melucasleite/mini-kitchen/dados.png

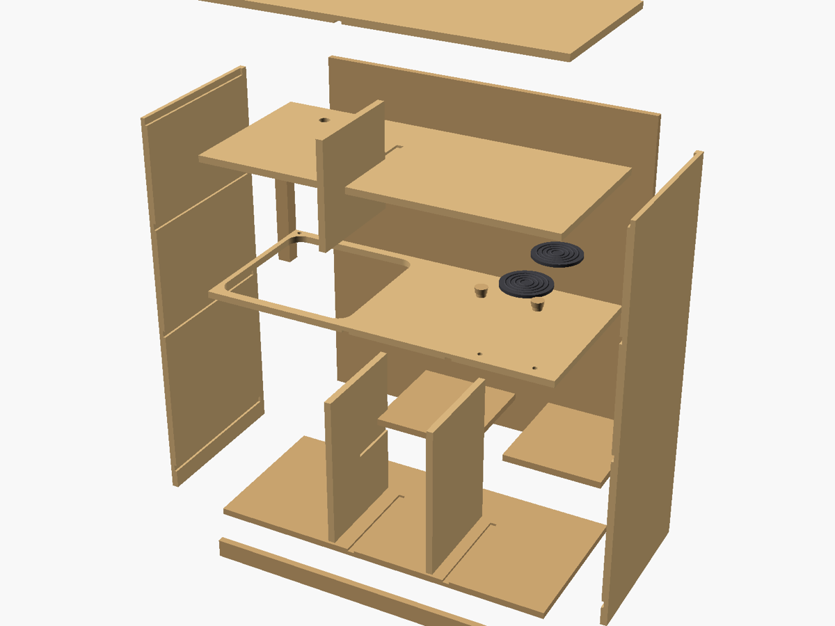
dados.png
