melucasleite/mini-kitchen/front.png

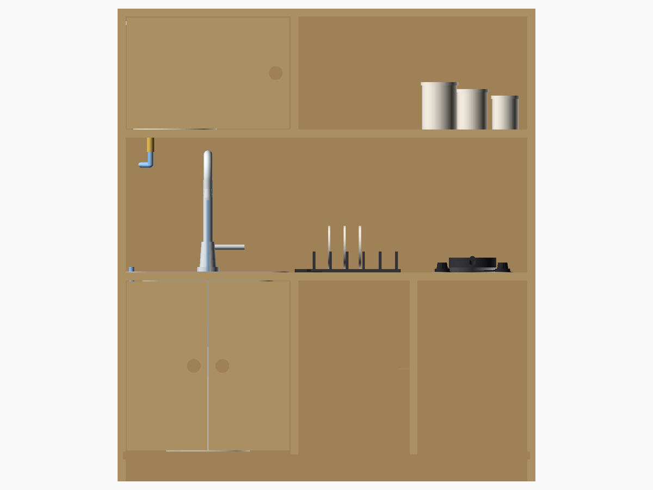
front.png
