melucasleite/mini-kitchen/iso.png

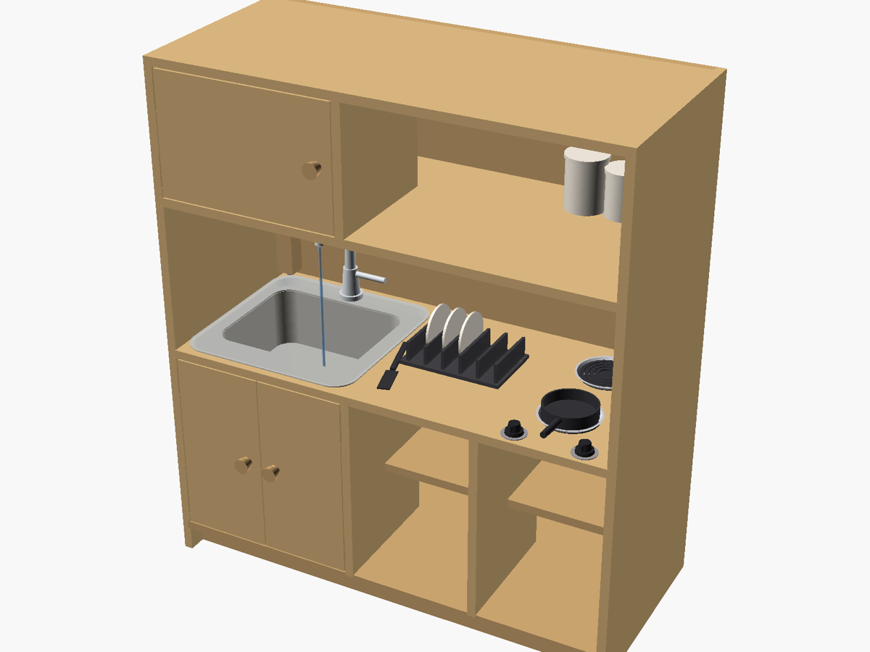
iso.png
