melucasleite/mini-kitchen/open.png

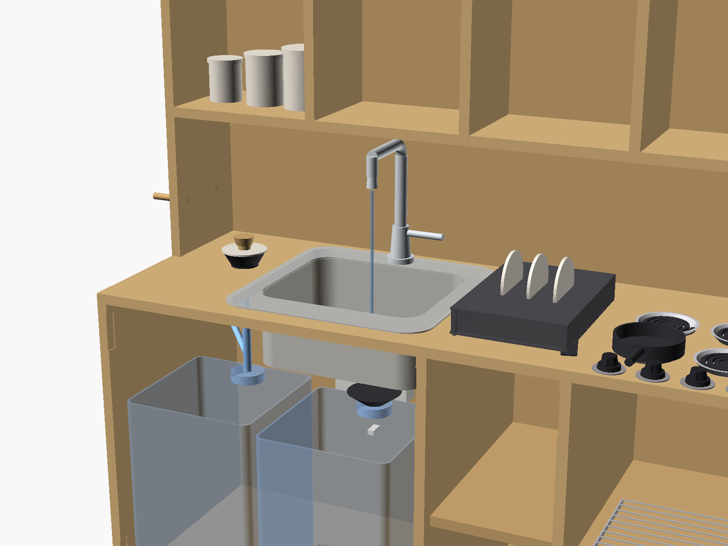
open.png
