melucasleite/mini-kitchen/previews/back-iso.png

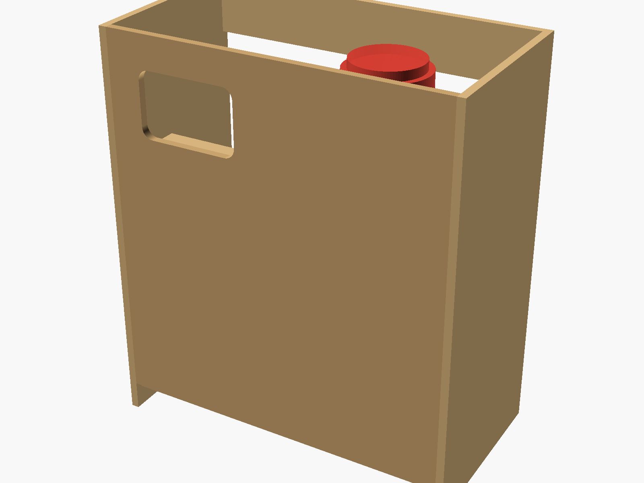
previews/back-iso.png
