melucasleite/mini-kitchen/previews/bay_top.png

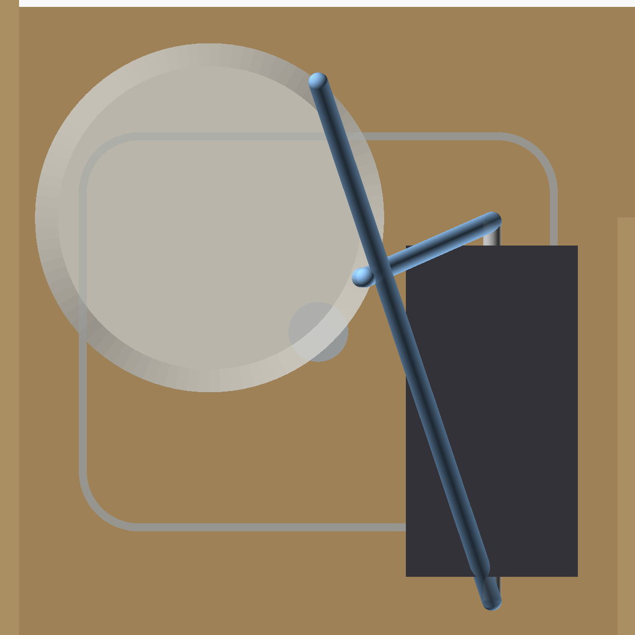
previews/bay_top.png
