melucasleite/mini-kitchen/previews/burner_side.png

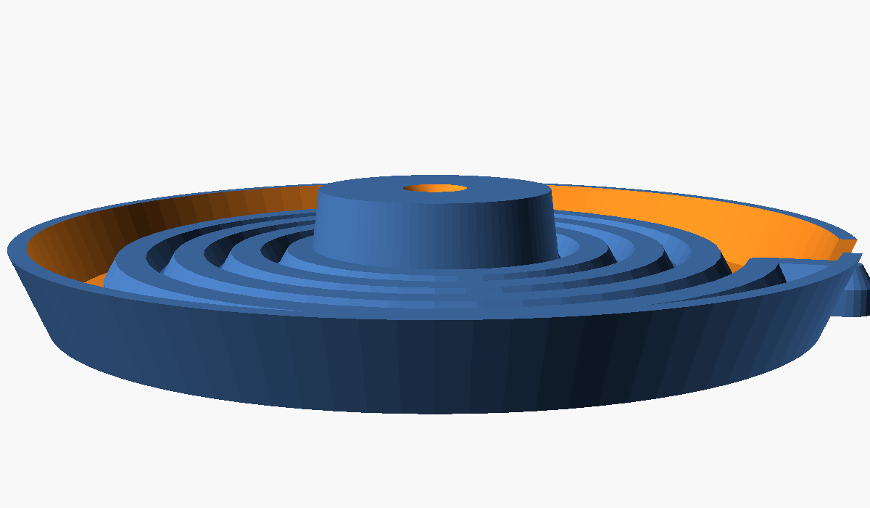
previews/burner_side.png
