melucasleite/mini-kitchen/previews/exploded.png

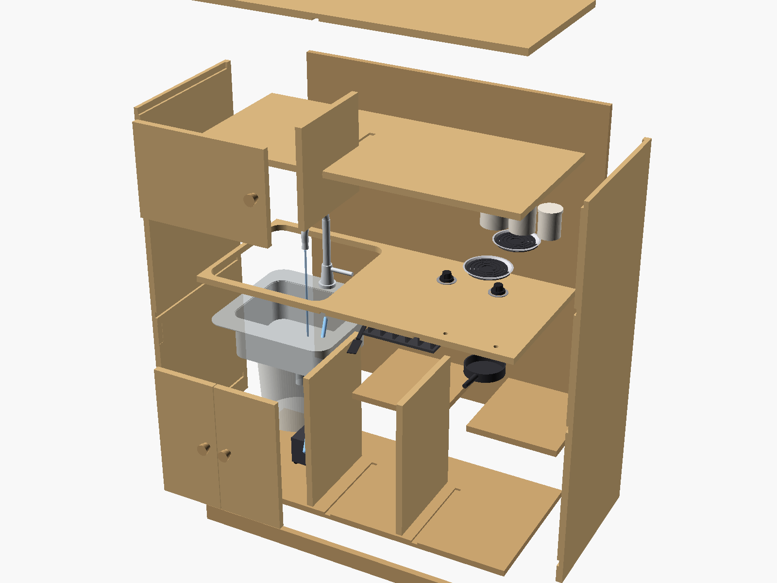
previews/exploded.png
