melucasleite/mini-kitchen/previews/faucet_close.png

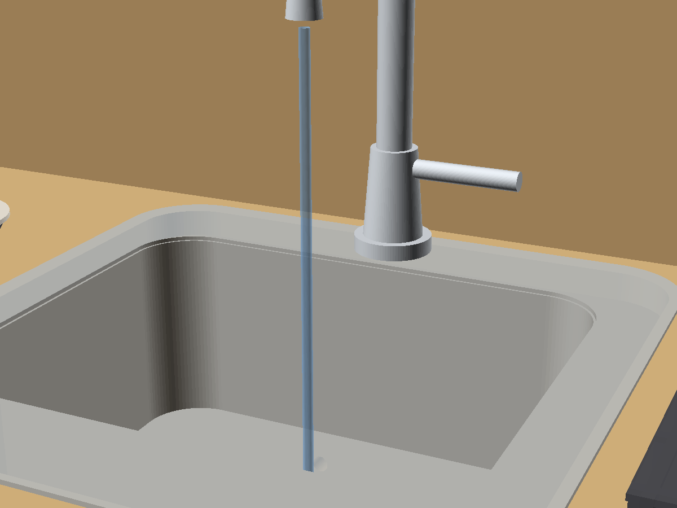
previews/faucet_close.png
