melucasleite/mini-kitchen/previews/front --camera=19,9,21.5,90,0,0,112 --projection=o.png

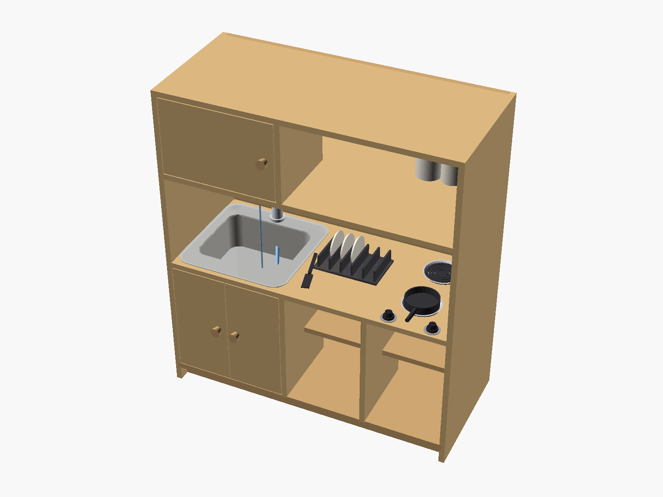
previews/front --camera=19,9,21.5,90,0,0,112 --projection=o.png
