melucasleite/mini-kitchen/previews/front.png

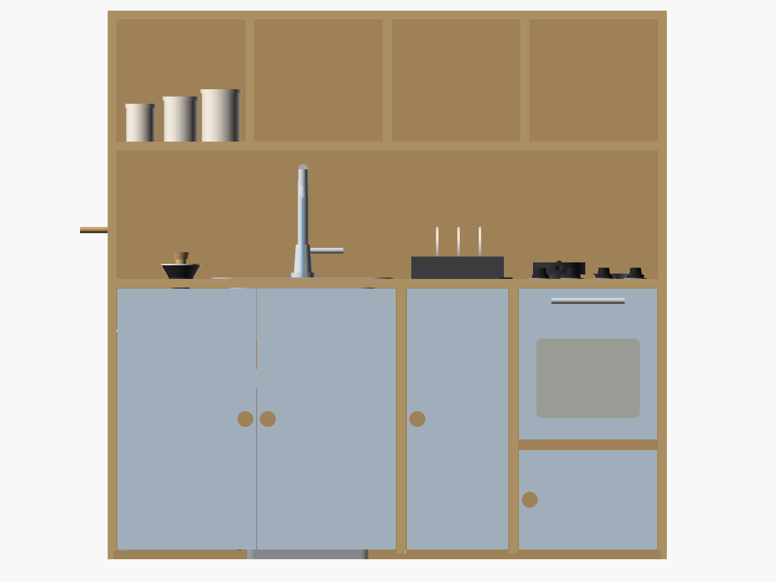
previews/front.png
