melucasleite/mini-kitchen/previews/hole-cover.png

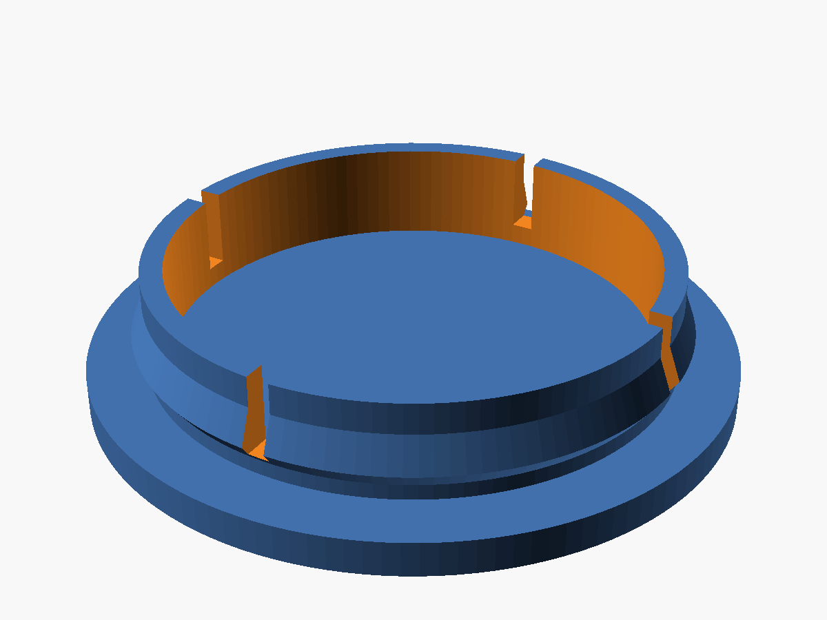
previews/hole-cover.png
