melucasleite/mini-kitchen/previews/iso.png

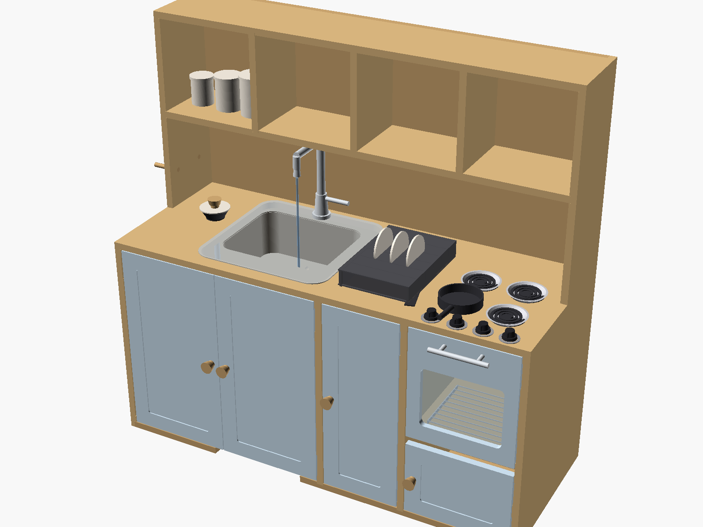
previews/iso.png
