melucasleite/mini-kitchen/previews/open.png

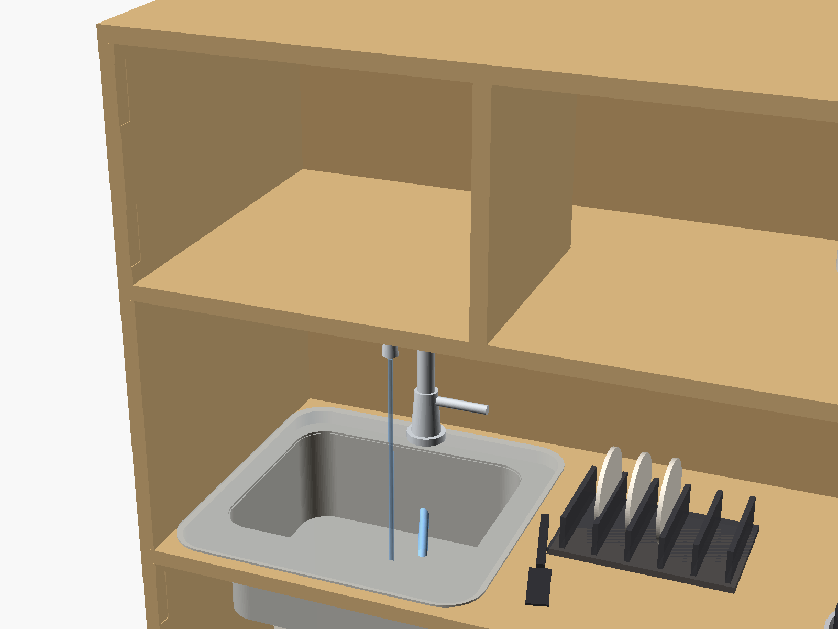
previews/open.png
