melucasleite/mini-kitchen/previews/pickup.png

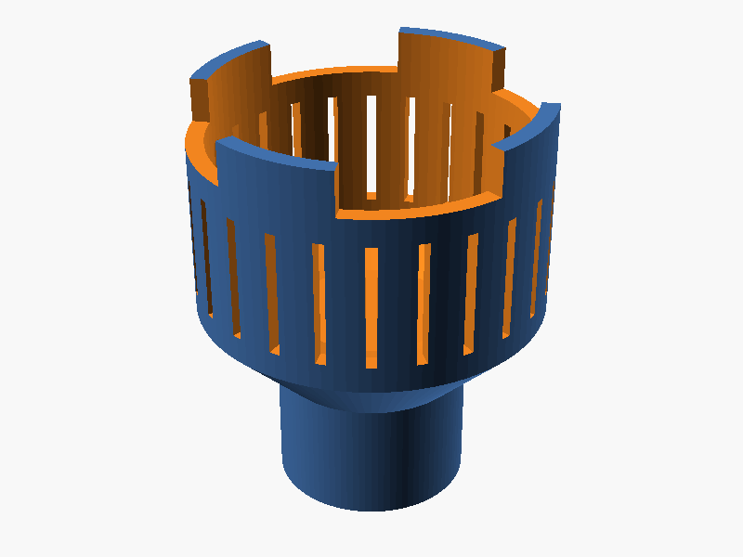
previews/pickup.png
