melucasleite/mini-kitchen/previews/pickup_cut.png

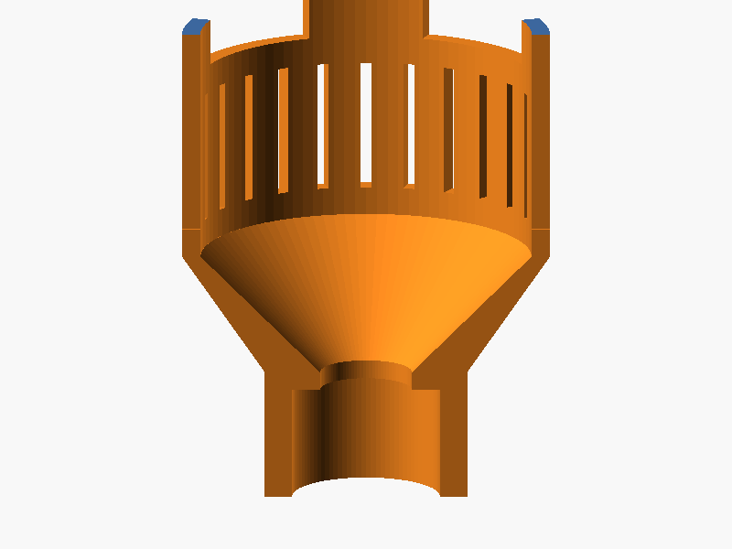
previews/pickup_cut.png
