melucasleite/mini-kitchen/previews/plumbing.png

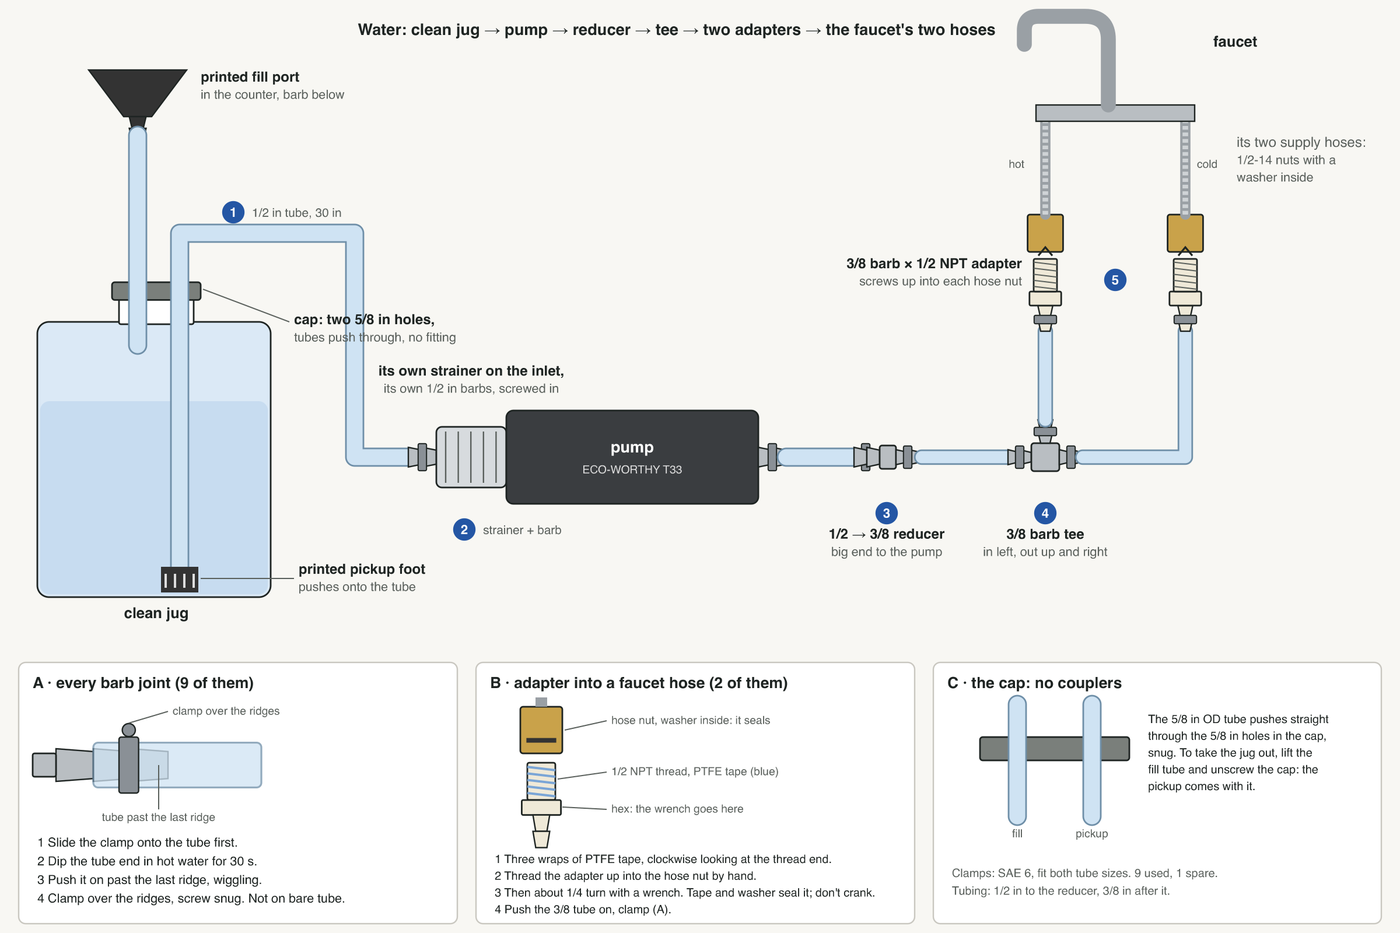
previews/plumbing.png
