melucasleite/mini-kitchen/previews/rack.png

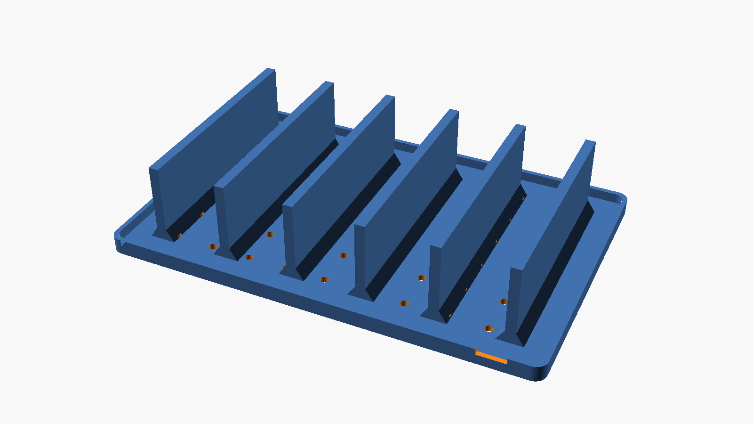
previews/rack.png
