melucasleite/mini-kitchen/previews/sheets/S1-sides-and-kick.svg.png

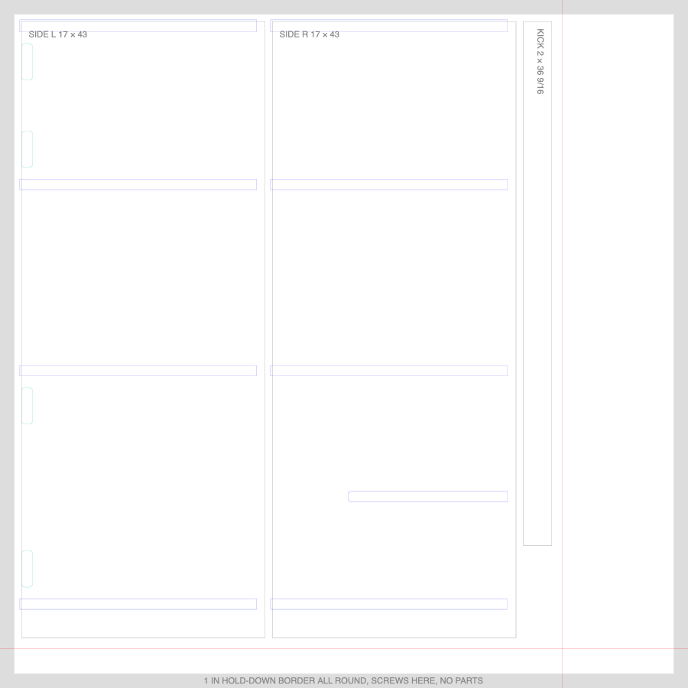
previews/sheets/S1-sides-and-kick.svg.png
