melucasleite/mini-kitchen/previews/sheets/S2-back-and-doors.svg.png

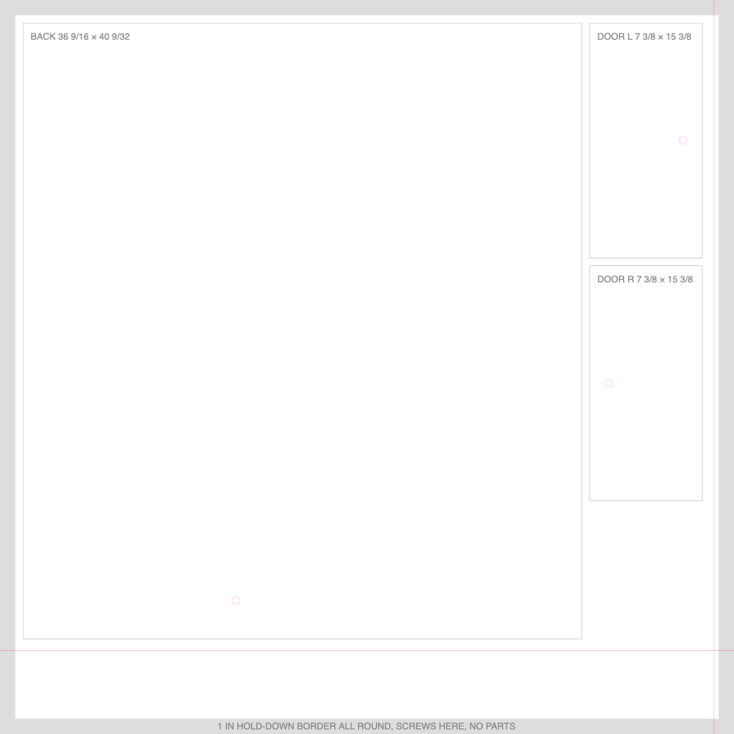
previews/sheets/S2-back-and-doors.svg.png
