melucasleite/mini-kitchen/previews/sheets/S3-counter-bottom-cupboard-door-mid-shelves.svg.png

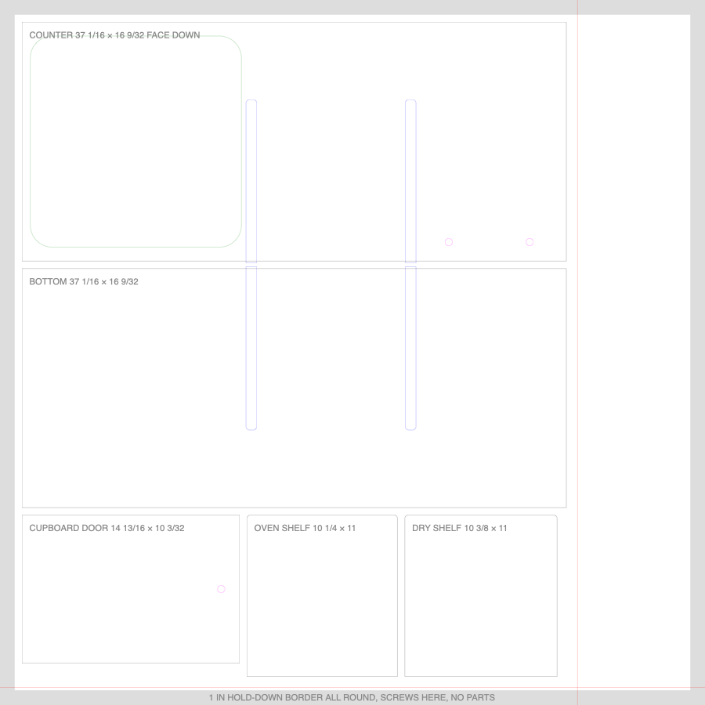
previews/sheets/S3-counter-bottom-cupboard-door-mid-shelves.svg.png
