melucasleite/mini-kitchen/previews/sheets/S4-upper-shelf-top-dividers.svg.png

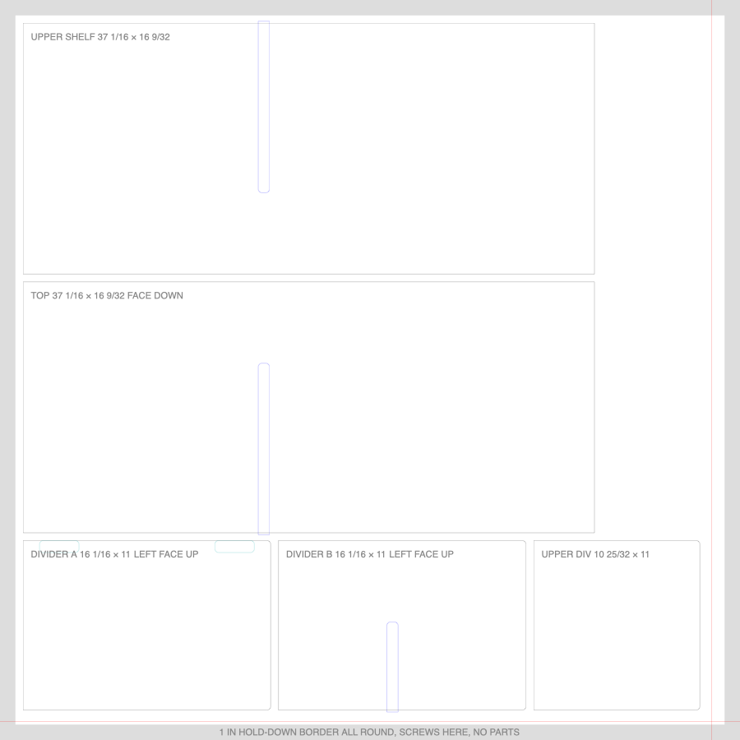
previews/sheets/S4-upper-shelf-top-dividers.svg.png
