melucasleite/mini-kitchen/previews/toys.png

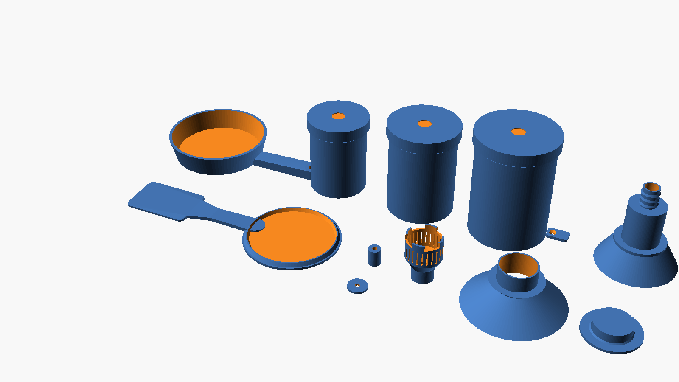
previews/toys.png
