melucasleite/mini-kitchen/previews/under.png

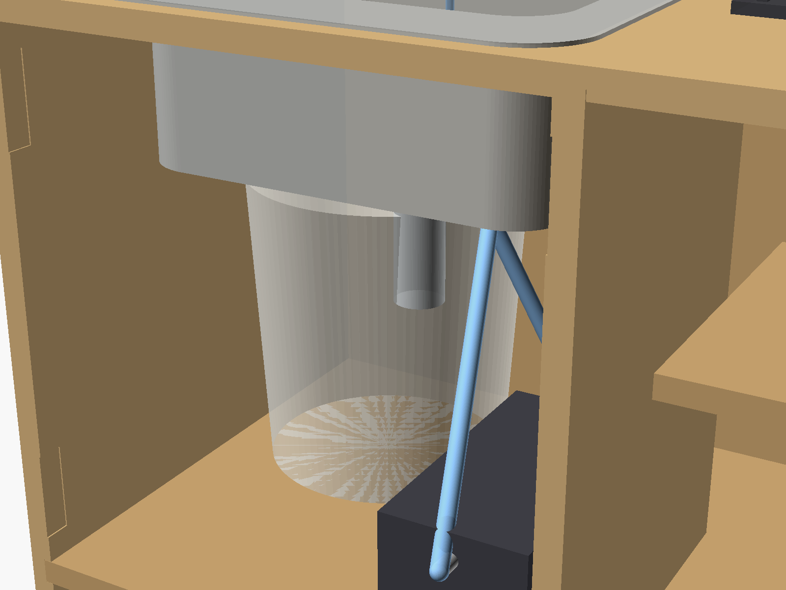
previews/under.png
