melucasleite/mini-kitchen/BOM.md

# Bill of materials

Amazon prices are what was paid on 13 Oct 2026 (two orders, tax on its own line). Plywood, glue, dowel, paint, primer and #8 wood screws are Home Depot, before tax. `[x]` = in hand. Every row counts in the total, including what you already had.
Polyurethane, sandpaper, PTFE thread tape and
filament are assumed on hand. Generated by `gen_html.py` from the same list as the shop sheet.

Water loop: clean jug → printed pickup foot → 1/2 in tube through the jug cap → the pump's own strainer → 12 V demand pump on the back panel → 1/2 to 3/8 barb reducer → 3/8 in tube → tee → one 1/2 NPT × 3/8 barb adapter into each faucet supply nut. Sink → basket strainer → printed funnel in the dirty jug's cap. A fill port in the counter refills the clean jug. The pressure switch runs the pump only while the tap is open; two float switches in series, through a relay, stop it when the clean jug is empty or the dirty jug is full.

| Bought | Item | Store | Each | Qty | Subtotal | Notes |
|:-:|---|---|---:|---:|---:|---|
| | **Wood and finish** | | | | **351.83** | |
| [x] | [PureBond red oak plywood 3/4 in × 4 ft × 8 ft](https://www.homedepot.com/p/Columbia-Forest-Products-3-4-in-x-4-ft-x-8-ft-PureBond-Red-Oak-Plywood-165956/100046409) | Home Depot | 95.00 | 3 | 285.00 | Columbia Forest Products 165956. Three sheets ripped in half make the six 48 × 48 panels on hand; the cut sheets use five. Measured 0.715 to 0.725 in; dados cut 0.735. Budget price, not read from the page. |
| [x] | [Red oak iron-on edge banding, 13/16 in × 50 ft](https://www.amazon.com/dp/B0G43Y98DV) | Amazon | 20.00 | 1 | 20.00 | POWERTEC 72371, pre-glued (the Edge Supply roll went out of stock). About 44 ft used: every front edge of the carcass, the open shelves included, and all four edges of five doors. |
| [x] | [Titebond III wood glue, 8 oz](https://www.homedepot.com/p/Titebond-III-8-oz-Ultimate-Wood-Glue-1413/202960636) | Home Depot | 7.49 | 1 | 7.49 | Titebond 1413. Waterproof. Every dado gets it. |
| [x] | [BEHR Premium cabinet & trim enamel, semi-gloss, 1 qt, light blue](https://www.homedepot.com/p/BEHR-PREMIUM-1-qt-52-White-Semi-Gloss-Enamel-Interior-Exterior-Cabinet-Door-Trim-Paint-712004/312376157) | Home Depot | 23.38 | 1 | 23.38 | The five doors, in a very pale powder blue: pick a light blue at the paint desk and ask for it three steps lighter. Budget price. |
| [x] | [KILZ 2 primer, 1 qt](https://www.homedepot.com/p/KILZ-KILZ-2-ALL-PURPOSE-1-qt-White-Interior-Exterior-Multi-Surface-Primer-Sealer-and-Stain-Blocker-20902/100144601) | Home Depot | 12.98 | 1 | 12.98 | KILZ 20902. One coat on the five doors before the enamel; plywood drinks paint. |
| [x] | [1/2 in × 36 in oak dowel](https://www.homedepot.com/p/Waddell-1-2-in-x-36-in-Oak-Round-Dowel-6512U/100033232) | Home Depot | 2.98 | 1 | 2.98 | Two 3 in pegs cut from it, glued through the left side at her shoulder height: apron and hand towel. Budget price. |
| | **Fasteners** | | | | **30.82** | |
| [x] | [#8 × 1-1/4 in flat head wood screws, 100](https://www.homedepot.com/p/Everbilt-8-x-1-1-4-in-Phillips-Flat-Head-Zinc-Plated-Wood-Screw-100-Pack-801832/204275496) | Home Depot | 7.97 | 1 | 7.97 | Everbilt 801832, zinc. About 89 used: three screws through every dado joint on top of the glue, plus the back, shelves and one through each burner. Countersink them all. |
| [x] | [#6 × 1/2 in flat head wood screws, 100](https://www.amazon.com/dp/B06ZZBG6DC) | Amazon | 7.09 | 1 | 7.09 | Rok Hardware, zinc. Four hold the oven window clips, four the pump's feet, four the wiring box to the back panel and four its lid. |
| [x] | [3/8 in face-grain oak plugs, 100](https://www.amazon.com/dp/B00U0XFVEM) | Amazon | 15.76 | 1 | 15.76 | WidgetCo. Flat plugs for the countersunk heads on the two outside faces and the top, about 36 used. |
| | **Doors and hardware** | | | | **23.65** | |
| [x] | [2-1/2 in stainless butt hinges, 10-pack](https://www.amazon.com/dp/B097QT8DF9) | Amazon | 7.49 | 1 | 7.49 | Zorveiio, satin nickel, 66 × 38 mm, 1.4 mm leaves, screws included. Two on each of the five doors. The cabinet leaf sits flush in a 1.4 mm CNC recess, so the door leaf alone takes up the 3/32 in reveal. |
| [x] | [1.3 in unfinished wood knobs, 20-pack](https://www.amazon.com/dp/B0CJQ4HFDR) | Amazon | 9.99 | 1 | 9.99 | Cangder mushroom knobs, solid wood, M4 × 30 mm screws included. Four on the doors, each on a printed bushing in a 1/2 in CNC hole and centred on the stile, clear of the Shaker panel; one on the fill-port lid. Fifteen spare. The stove knobs are printed. |
| [x] | [6 in stainless bar pull, 96 mm centres](https://www.amazon.com/dp/B01A7D4LIG) | Amazon | 6.17 | 1 | 6.17 | Pandora solid stainless. The oven door handle, above the window; the CNC dimples its two screw holes on the inside face. |
| | **Sink and faucet** | | | | **155.72** | |
| [x] | [Elkay Dayton 15 in drop-in bar sink](https://www.amazon.com/dp/B001289TIS) | Amazon | 74.99 | 1 | 74.99 | D115151. 15 × 15 rim, 12 × 10 × 5 bowl, 2 in drain, one 1 1/2 in faucet hole, 14 3/8 in cutout, clips included. The 5 in bowl leaves room for a 14 in jug under it. It sits 3/4 in back of centre in its bay so the drain lands over the dirty jug's neck. |
| [x] | [ARCORA single-handle bar faucet, brushed nickel, with supply lines](https://www.amazon.com/dp/B0D7PXX12L) | Amazon | 43.19 | 1 | 43.19 | 9.3 in tall under 10 1/2 in of headroom, spout 7 in up, 5 in reach, 1.26 to 1.5 in hole. Hoses end in 1/2-14 NPSM nuts for the adapters below; if yours are 3/8 compression, use 3/8 compression × 3/8 barb fittings (B07DJ451LM) instead. |
| [x] | [Niagara Tri-Max 0.5 / 1.0 / 1.5 GPM aerator](https://www.amazon.com/dp/B0096C2IVC) | Amazon | 8.50 | 1 | 8.50 | Niagara Conservation N3610CH, dual thread, three click-stop flows. Run it on 0.5 so the sink never fills faster than it drains. Play water, not drinking water. |
| [x] | [2 in bar sink drain with basket strainer](https://www.amazon.com/dp/B0G1BCT47B) | Amazon | 9.99 | 1 | 9.99 | Phivan, stainless, fits the Elkay's 2 in drain. Hangs about 1 1/2 in under the bowl, straight over the funnel in the dirty jug. Keeney K5421 (B002JFUOBY) is the fallback. |
| [x] | [1-1/2 in × 6 in sink tailpiece](https://www.amazon.com/dp/B000M2UJSO) | Amazon | 5.99 | 1 | 5.99 | Plumb Pak PP905W. Already in the cart; cut it to a 1 in stub on the strainer to aim the stream into the funnel, or leave it out. |
| [x] | [Plumber's putty, 9 oz](https://www.amazon.com/dp/B006E356S8) | Amazon | 4.54 | 1 | 4.54 | Oatey 31177. Under the strainer flange. |
| [x] | [GE Advanced Silicone 2 kitchen & bath sealant, clear, 2.8 oz](https://www.amazon.com/dp/B000PSE46S) | Amazon | 8.52 | 1 | 8.52 | Bead under the sink rim and around the cutout edge; a thin bead round the acrylic in its pocket. |
| | **Water** | | | | **101.73** | |
| [x] | Two 5 gal square water jugs, 10 × 10 × 14 in | On hand | — | 2 | — | Yours, 2 1/4 in opening at the back edge of the top, both standing neck to the back. Clean on the left: pickup foot inside on its tube through a drilled cap, a side-mount float low on its back wall. Dirty on the right, on the floor in the notch, printed funnel in a 1 1/2 in hole in its cap. Already yours; no price to count. |
| [x] | [ECO-WORTHY 12 V demand pump, 3.5 GPM, 45 psi, with strainer and fittings](https://www.amazon.com/dp/B0BVMDL77Y) | Amazon | 44.99 | 1 | 44.99 | Model T33-12V. Its pressure switch runs it when the faucet opens and stops it when it closes; self-priming, can run dry. Use its own strainer and 1/2 in straight-thread barbs, not NPT. Screwed to the back panel behind the jugs; switch turned toward 25 psi. |
| [x] | [1/2 in ID × 5/8 in OD clear vinyl tubing, 10 ft](https://www.amazon.com/dp/B0CYSM69DW) | Amazon | 8.99 | 1 | 8.99 | Pickup line from the foot in the clean jug up through its cap to the pump's strainer and inlet; pump outlet to the reducer; and 9 in from the fill port down to the cap. About 7 ft used. |
| [x] | [1/2 in to 3/8 in stainless barb reducer, 2-pack](https://www.amazon.com/dp/B088LQCQ4D) | Amazon | 10.99 | 1 | 10.99 | Beduan 304 stainless: 1/2 in tube from the pump on one end, 3/8 in tube to the tee on the other, a clamp on each. One spare. |
| [x] | [3/8 in ID × 1/2 in OD clear vinyl tubing, 10 ft](https://www.amazon.com/dp/B07NQSNBTG) | Amazon | 7.88 | 1 | 7.88 | Eastman 98620, FDA-compliant PVC. About 3 ft used: reducer to tee to the two faucet adapters. |
| [x] | [3/8 in stainless barb tee](https://www.amazon.com/dp/B08G1RJ38P) | Amazon | 8.99 | 1 | 8.99 | Metaland 3/8 × 3/8 × 3/8. Splits the pump's outlet to both faucet supply lines so every handle position gives water. |
| [x] | [3/8 in barb × 1/2 in NPT male nylon adapter, 6-pack](https://www.amazon.com/dp/B08G1833GN) | Amazon | 7.99 | 1 | 7.99 | JoyTube. Screws straight into the faucet's 1/2-14 NPSM supply nuts (the hose's own cone washer seals it), 3/8 in tube on the barb. One per line, four spare. |
| [x] | [SAE 6 stainless hose clamps (3/8 to 7/8 in), 10-pack](https://www.amazon.com/dp/B01MQCU44A) | Amazon | 11.90 | 1 | 11.90 | Covers both tube sizes; one on every barb, nine used, one spare. |
| | **Electrical** | | | | **71.12** | |
| [x] | [12 V 10 A power supply, 120 W, 5.5 × 2.1 mm barrel](https://www.amazon.com/dp/B0D5CKC9V1) | Amazon | 20.98 | 1 | 20.98 | Desktop supply with a barrel-to-screw-terminal adapter in the box. The pump can pull 6 A. Its plug is the adult off switch. |
| [x] | [Side-mount float switch, M16, 2-pack](https://www.amazon.com/dp/B08B4JQHN9) | Amazon | 5.99 | 1 | 5.99 | mxuteuk DPL-1-BK, polypropylene, both used. One through a 5/8 in hole low on the clean jug's back wall, 2 in up: it opens when the water drops below it and the pump stops before it can run dry. The other high on the dirty jug's back wall, 12 in up, set the other way: it opens when the dirty water lifts it, so the sink cannot overfill the jug. In series on the relay coil; rated 0.5 A, so they never carry the pump. |
| [x] | [12 V 30 A automotive relay with socket, 5-pack](https://www.amazon.com/dp/B00RWV470O) | Amazon | 13.59 | 1 | 13.59 | ESUPPORT 5-pin. Both float switches in series on the coil (85/86), supply positive to 30, pump positive off 87: clean jug empty or dirty jug full, no coil, no pump. Lies in the printed wiring box, held by two zip ties. Four spare. |
| [x] | [2-pin waterproof pigtail plugs, 5 pairs](https://www.amazon.com/dp/B01A6LTK44) | Amazon | 7.59 | 1 | 7.59 | MUYI, pre-wired, 4 in of 18 AWG on each half: no crimping. One pair on each float lead at the top of its jug's back wall, joined to the float wires and to the run to the wiring box with in-line lever connectors. Unplug and the jug walks away. Three pairs spare. |
| [x] | [18 AWG two-conductor red/black wire, 25 ft](https://www.amazon.com/dp/B0G9NYN463) | Amazon | 7.99 | 1 | 7.99 | Copper-clad aluminium, fine at 12 V and these lengths. Three runs into the wiring box: the supply pair from the barrel adapter through the cord hole (2 ft), and one pair to each jug's plug (clean about 3 ft, dirty about 2 ft). Red is the float's feed, black its return. |
| [x] | [Lever wire connectors, 32-piece kit](https://www.amazon.com/dp/B0B28GQVVG) | Amazon | 14.98 | 1 | 14.98 | XALXMAW: 18 one-in-one-out, 6 one-in-two-out, 4, 2 and 2 of the bigger splitters; 24–12 AWG. 14 used: three 1-in-2-out and three 1-in-1-out in the wiring box's labelled slots, and four 1-in-1-out at each jug where the float's leads meet its plug and the plug meets the run. Strip, lift the lever, push in, close it: no crimping. |
| | **Oven, stove and dishes** | | | | **52.18** | |
| [x] | [8 × 10 in clear cast acrylic, 1/8 in, 2-pack](https://www.amazon.com/dp/B0CQ2D2VCN) | Amazon | 9.99 | 1 | 9.99 | KAITELA, cast. It drops into the 10 3/16 × 8 3/16 in pocket on the oven door's inside face as it comes, film off, nothing to cut. One spare sheet. |
| [x] | [Stainless cooling rack, 9.7 × 7.3 in, 2-pack](https://www.amazon.com/dp/B07NVBF3W7) | Amazon | 8.29 | 1 | 8.29 | P&P CHEF. One is the oven rack, on the oak oven floor behind the window. The other is a spare or a second shelf. |
| [x] | [Small dish drying rack, 7.7 in wide](https://www.amazon.com/dp/B09SG532Q8) | Amazon | 21.69 | 1 | 21.69 | Rubber-footed slim rack for the drying bay counter, long axis front to back; the bay is 8 1/2 in wide, so anything under 8 in across works. |
| [x] | [#8-32 × 2 in stainless machine screws, 30](https://www.amazon.com/dp/B0G7Y5KY1R) | Amazon | 6.99 | 1 | 6.99 | Twidec, pan head. Four hold the stove knobs: up from under the counter, through a printed washer and the knob's boss, into the nut captured in the knob. |
| [x] | [#8-32 machine screw nuts, 100](https://www.amazon.com/dp/B000BQMMFY) | Amazon | 5.22 | 1 | 5.22 | Hillman, zinc. One drops into the hex pocket in each stove knob before its boss is glued in. |
| | **Safety** | | | | **11.58** | |
| [x] | [Furniture anti-tip strap kit](https://www.amazon.com/dp/B000FJRYAA) | Amazon | 11.58 | 1 | 11.58 | QuakeHOLD! 4160, two 15 in nylon straps. A 45 in hutch with a toddler on the oven door is a ladder. Strap the back to a stud. |
| | **Tax** | | | | **25.94** | |
| [x] | Sales tax on the two Amazon orders, less a $1.05 coupon | Amazon | 25.94 | 1 | 25.94 | $17.93 + $9.06 tax, −$1.05 coupon: the Amazon lines above plus this one come to the $442.70 charged. Home Depot prices are before tax. |

## Printed

All in `printed.scad`, STLs in `stl/`. Black PLA or ASA unless noted.

| Part | Qty | File | Notes |
|---|---:|---|---|
| Drip pan, 4 in | 4 | `stl/drip_pan.stl` | Silver or light grey. Sloped wall, centre hole; the coil's screw clamps it down. About 35 g each. |
| Coil element | 4 | `stl/coil.stl` | Black. Three-turn spiral with a 16 mm centre cap and a terminal tail, drops into the pan. One #8 × 1 1/4 in screw down through the cap holds coil and pan to the counter. About 25 g each. |
| Stove knob body | 4 | `stl/stove_knob.stl` | Black, prints face down, pointer up. The hexagon in the face is a pocket for an 8-32 nut: drop the nut in, glue the boss over it. About 18 g each. |
| Knob boss | 4 | `stl/knob_boss.stl` | The knob's 12.4 mm axle, prints standing. Glues into the knob face and turns in the 1/2 in counter hole; screw and washer from below. 3 g each. |
| Knob bezel | 4 | `stl/bezel.stl` | Tick ring glued round each knob hole, OFF at the back. 5 g each. |
| Knob washer, 20 mm | 4 | `stl/washer.stl` | Under each stove-knob screw head so it slides on the counter's underside when the knob turns. Print six, any colour. |
| Frying pan, 110 mm | 1 | `stl/pan.stl` | Black, prints flat; the handle runs from the base so nothing hangs in the air. About 45 g. |
| Spatula, 180 mm | 1 | `stl/spatula.stl` | Black, prints flat. About 25 g. |
| Plate, 100 mm | 4 | `stl/plate.stl` | Light colour, for the dish rack. About 20 g each; print six if you like. |
| Canisters with lids, S/M/L | 3 | `stl/canister-*.stl, stl/lid-*.stl` | Light colour cans, contrast lids, lids dimple-side down. They live on the first open shelf, where she can see them. About 150 g the set. |
| Door-knob bushing, 1/2 in OD × 3/16 bore | 4 | `stl/bushing.stl` | Presses into each door's CNC'd knob hole so the wood knob's 8-32 screw runs centred. 2 g each; print five. |
| Fill port | 1 | `stl/fill_port.stl` | Prints mouth down, no supports. An 80 mm funnel mouth standing 1 in above the counter, flange on the counter, 36 mm spout through the 1 1/2 in hole, 1/2 in barb below for the tube to the clean jug's cap. She refills the kitchen with her own pitcher. Black, about 45 g. |
| Fill port lid | 1 | `stl/fill_lid.stl` | Prints flat, ring up. An 84 mm disc with a ring that drops into the mouth; a spare wood knob screws to it from the ring side. Any colour, 20 g. |
| Pump pickup foot | 1 | `stl/pickup.stl` | Prints socket-side down, no supports. Slotted cup on four legs on the end of the pickup tube in the clean jug: water comes in through the slots, down the hollow cone and through a 10 mm bore into the tube. 36 mm across, so it drops through the jug's 2 1/4 in neck. Black, about 16 g. |
| Drain funnel | 1 | `stl/funnel.stl` | Prints mouth down, no supports. 100 mm mouth, 37.5 mm spout, 52 mm flange: the spout drops into a 1 1/2 in hole drilled in the dirty jug's cap (a 1 5/8 or 1 3/4 in hole saw works too) and the mouth sits under the strainer. The neck is at the jug's back edge and the drain {frac(DRAIN_OFF)} in from it, well inside the mouth. Black, about 25 g. |
| Cap plug | 2 | `stl/cap_plug.stl` | Prints flat. A disc with a spigot that fills the funnel hole in the dirty jug's cap: funnel out, plug in, carry the jug to the drain without a drip. One spare. Any colour, 10 g. |
| Wiring box | 1 | `stl/wire_box.stl` | Prints floor down, no supports. 152 × 102 × 38 mm. Screws to the back panel over the cord hole on four #6 screws in a rectangle. The relay stands on the right on two zip-tie saddles; six labelled slots in the middle hold the lever connectors on their sides (GND, +12V and SERIES 1-in-2-out; PUMP+, 85 and 87a 1-in-1-out), outputs left toward the outside wires, relay leads into the single ends from the right, so nothing crosses. Three notches let the outside wires in. Slot widths are WB_LCS in printed.scad if your connectors differ. Any colour, about 100 g. |
| Wiring box lid | 1 | `stl/wire_box_lid.stl` | Prints face down. 3 mm plate, four countersunk #6 × 1/2 into the box's corner bosses, vents over the relay coil, tongues that close the wire notches, a keeper bar that stops 1 mm in front of the connectors, 12 V on its face. About 50 g. |
| Oven window clip | 4 | `stl/window_clip.stl` | 22 × 14 × 3 mm plate, countersunk for a #6 × 1/2 screw. Four hold the acrylic in its pocket on the oven door's inside face, one per corner. Any colour, 2 g each. |

## Total

| | |
|---|---:|
| Amazon | 484.77 |
| Home Depot | 339.80 |
| **Total** | **824.57** |
| Still to buy | 0.00 |
