melucasleite/mini-kitchen/previews/parts/bezel.png

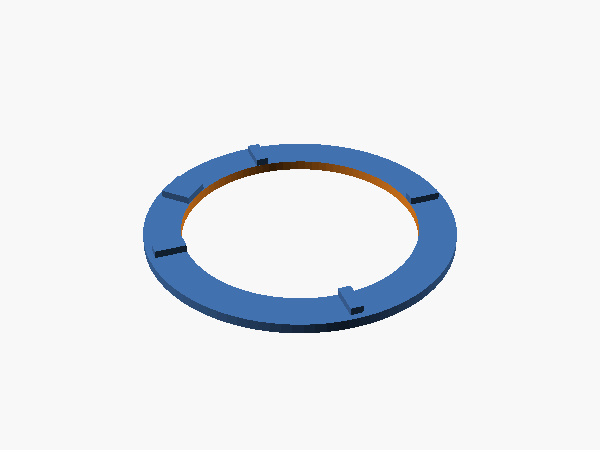
previews/parts/bezel.png
