melucasleite/mini-kitchen/previews/parts/bushing.png

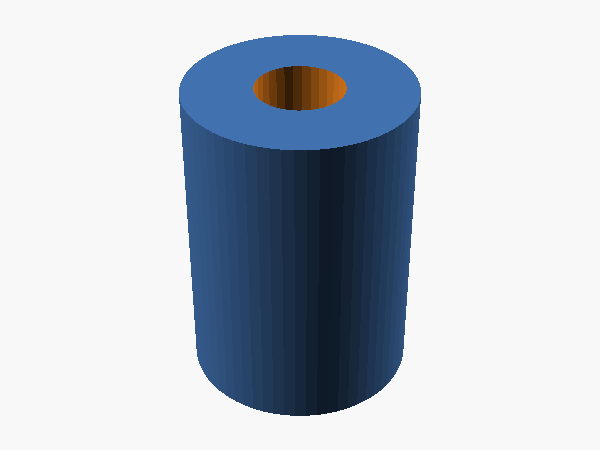
previews/parts/bushing.png
