melucasleite/mini-kitchen/previews/parts/cap_plug.png

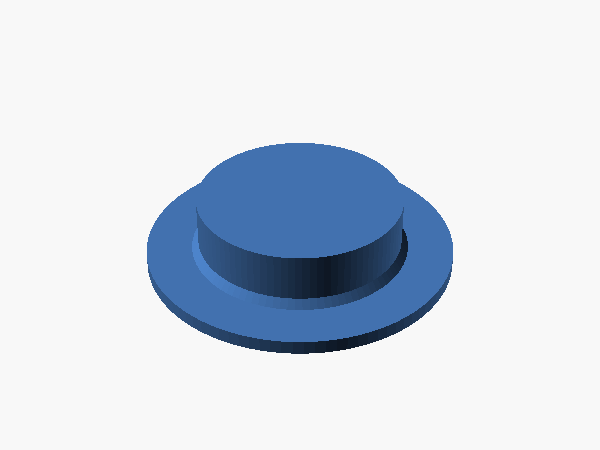
previews/parts/cap_plug.png
