melucasleite/mini-kitchen/previews/parts/coil.png

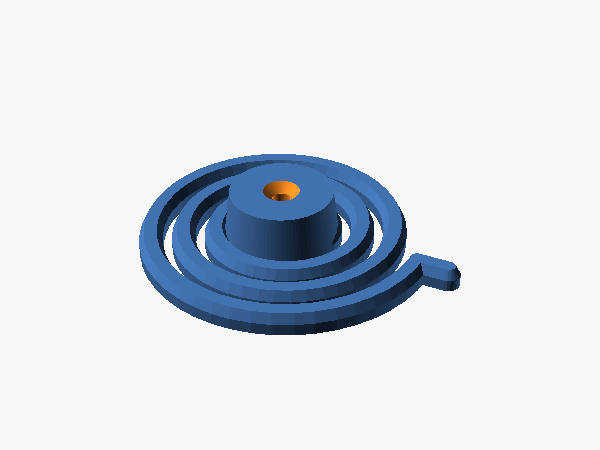
previews/parts/coil.png
