melucasleite/mini-kitchen/previews/parts/drip_pan.png

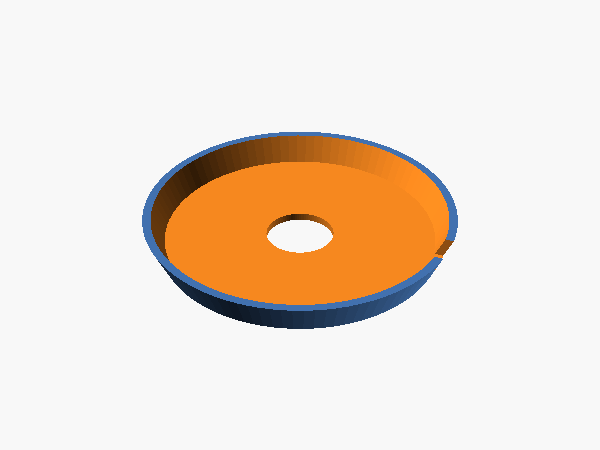
previews/parts/drip_pan.png
