melucasleite/mini-kitchen/previews/parts/fill_port.png

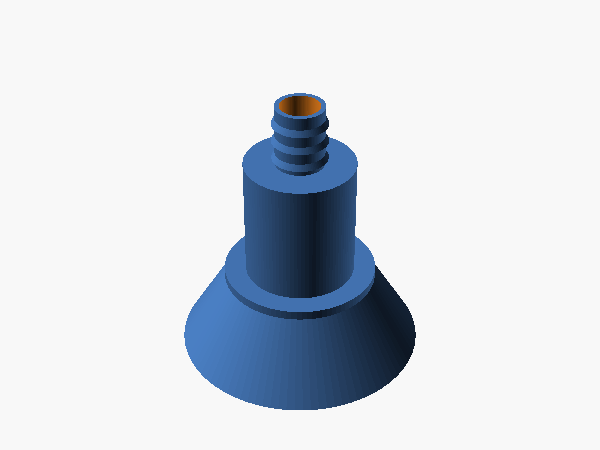
previews/parts/fill_port.png
