melucasleite/mini-kitchen/previews/parts/knob_boss.png

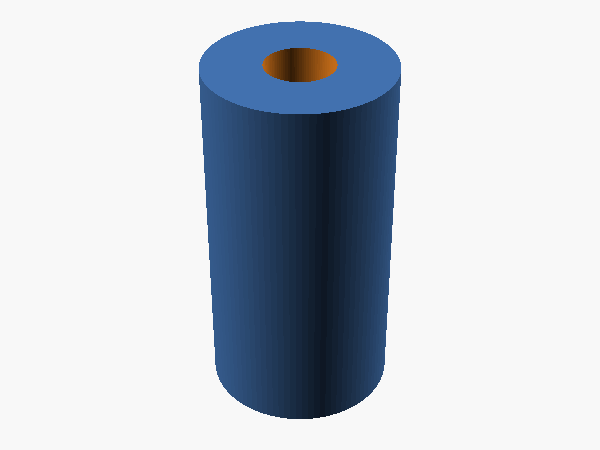
previews/parts/knob_boss.png
