melucasleite/mini-kitchen/previews/parts/lid-L.png

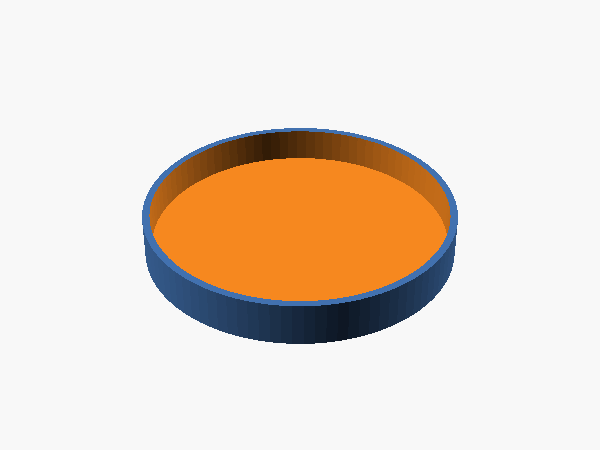
previews/parts/lid-L.png
