melucasleite/mini-kitchen/previews/parts/pan.png

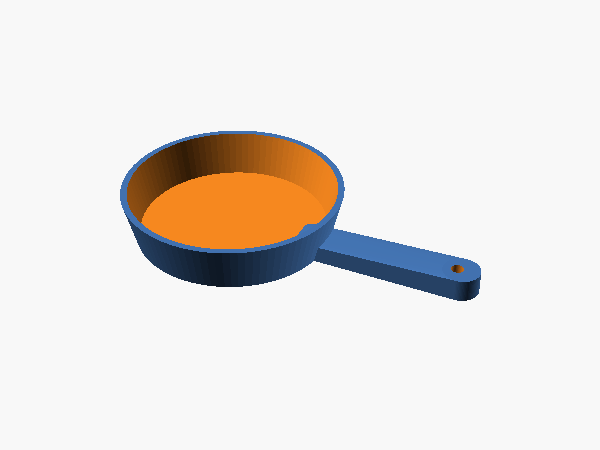
previews/parts/pan.png
