melucasleite/mini-kitchen/previews/parts/pickup.png

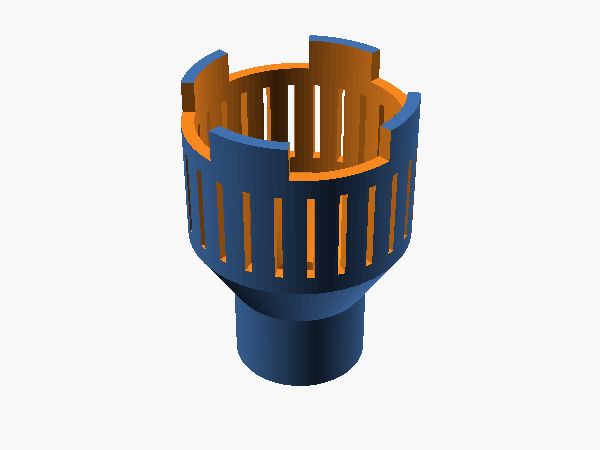
previews/parts/pickup.png
