melucasleite/mini-kitchen/previews/parts/plate.png

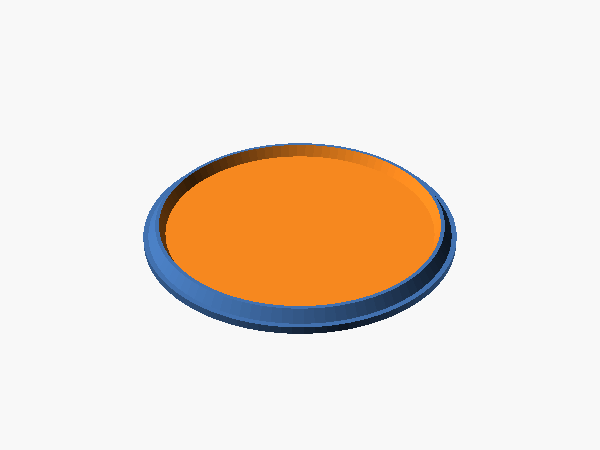
previews/parts/plate.png
