melucasleite/mini-kitchen/previews/parts/spatula.png

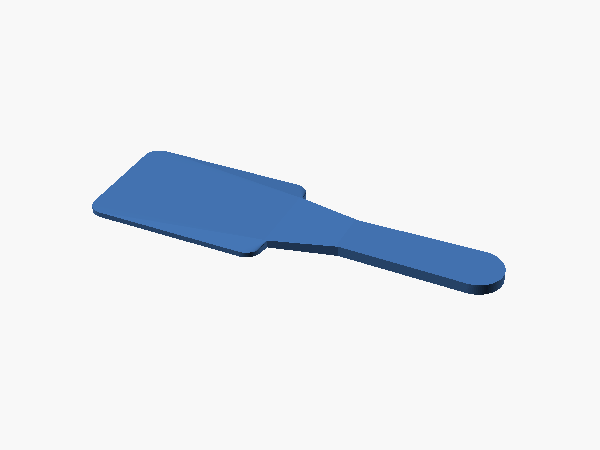
previews/parts/spatula.png
