melucasleite/mini-kitchen/previews/parts/stove_knob.png

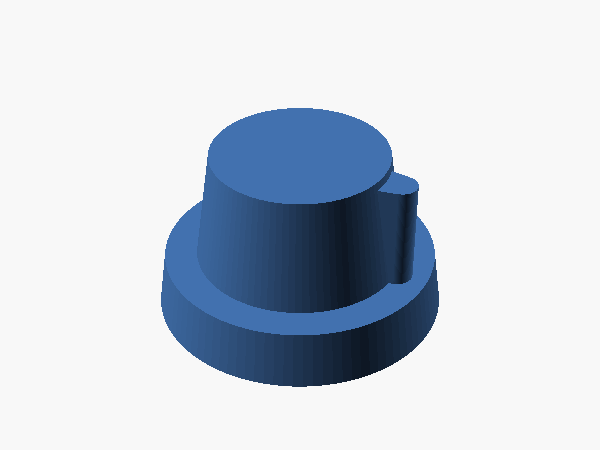
previews/parts/stove_knob.png
