melucasleite/mini-kitchen/previews/parts/window_clip.png

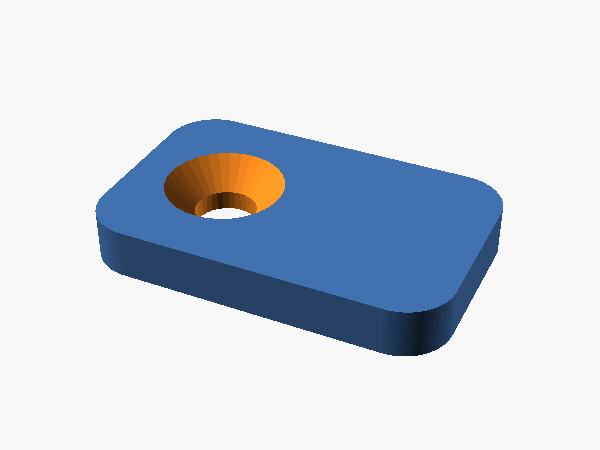
previews/parts/window_clip.png
