melucasleite/mini-kitchen/previews/parts/wire_box.png

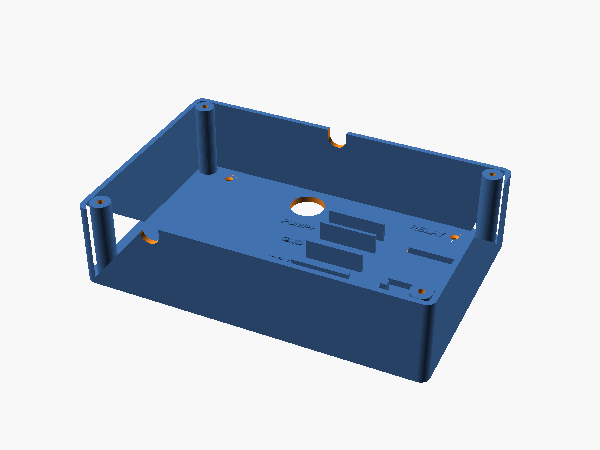
previews/parts/wire_box.png
