melucasleite/mini-kitchen/previews/parts/wire_box_lid.png

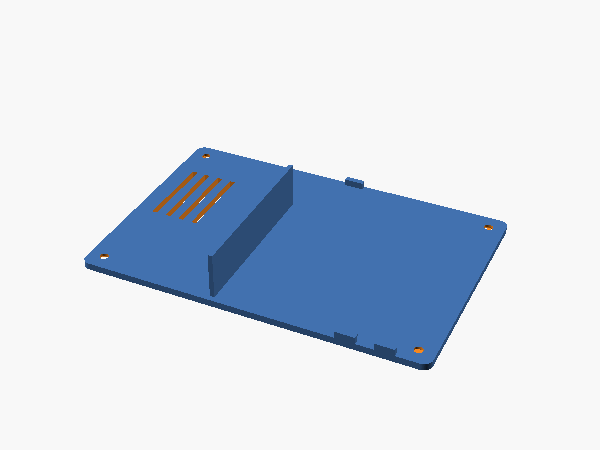
previews/parts/wire_box_lid.png
