melucasleite/mini-kitchen/plates/plate-3-drip-pans-silver.3mf

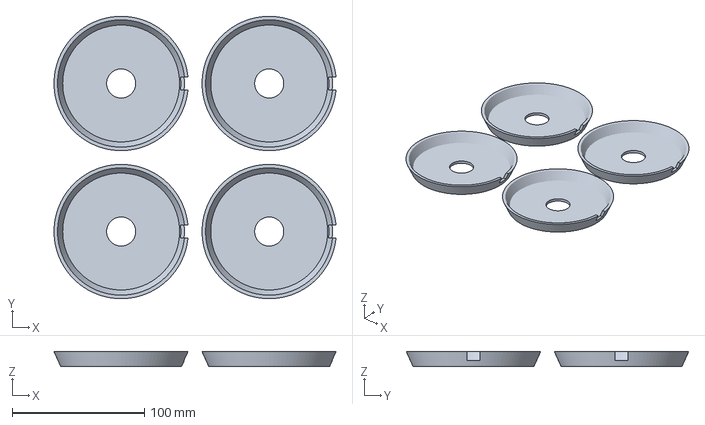
[picture p49: CAD file, 2026-10-24]
plates/plate-3-drip-pans-silver.3mf
213.3 x 213.6 x 11.0 mm
drip pan 1 x 4
