melucasleite/mini-kitchen/stl/pan.stl

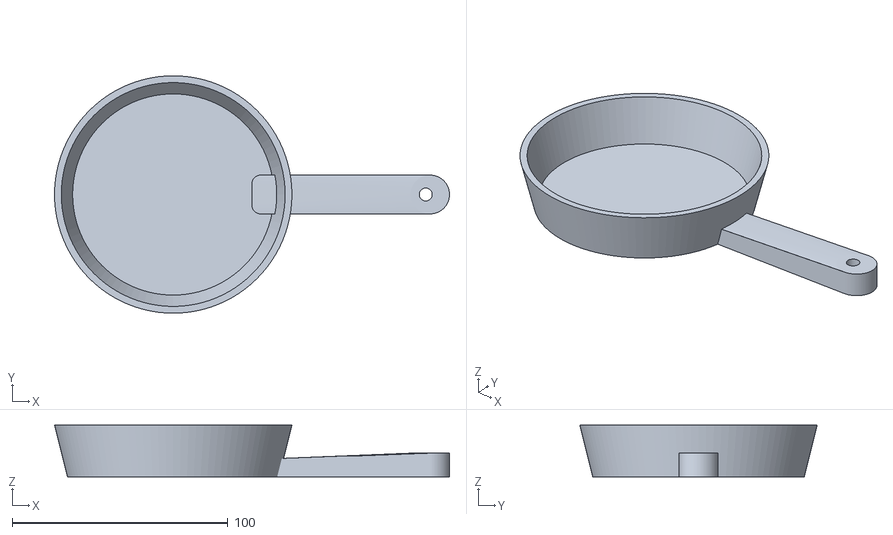
[picture p51: CAD file, 2026-10-24]
stl/pan.stl
183.0 x 110.0 x 24.0
