melucasleite/mini-kitchen/plates/plate-2-stove-black.3mf

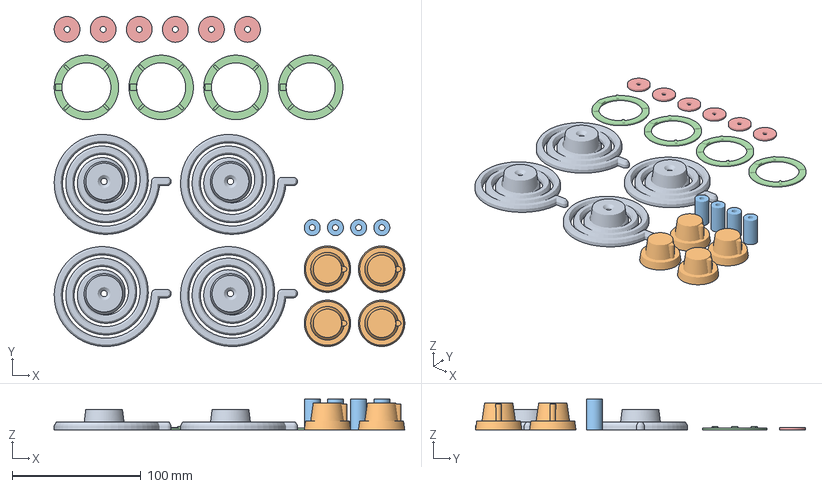
[picture p52: CAD file, 2026-10-24]
plates/plate-2-stove-black.3mf
272.0 x 256.0 x 24.0 mm
coil 1 x 4
stove knob 1 x 4
knob boss 1 x 4
bezel 1 x 4
washer 1 x 6
