melucasleite/mini-kitchen/stl/hinge-shims/hinge-shim-0.6mm.stl

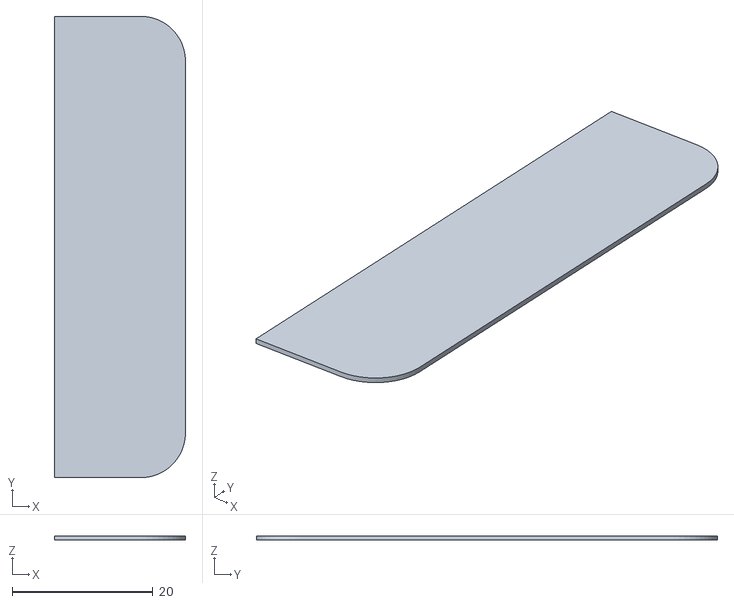
[picture p53: CAD file, 2026-10-24]
stl/hinge-shims/hinge-shim-0.6mm.stl
18.6 x 65.5 x 0.6
