melucasleite/mini-kitchen/stl/lid-L.stl

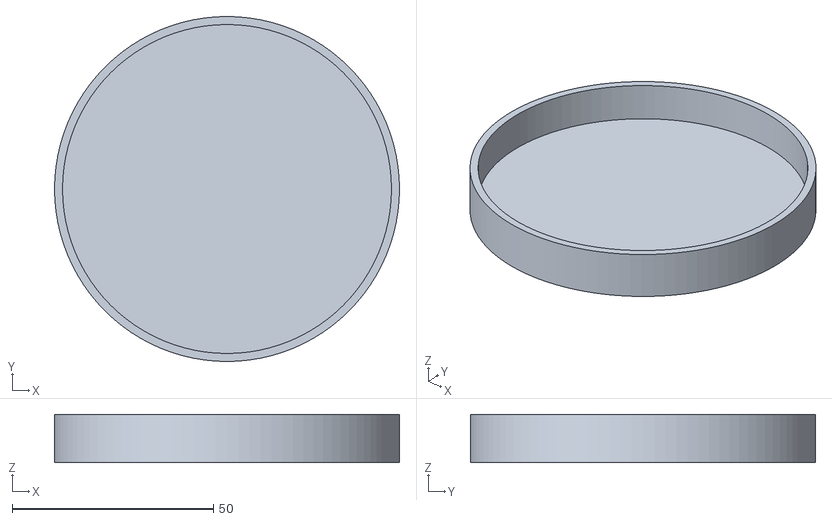
[picture p54: CAD file, 2026-10-24]
stl/lid-L.stl
85.8 x 85.8 x 12.0
