melucasleite/mini-kitchen/stl/wire_box_lid.stl

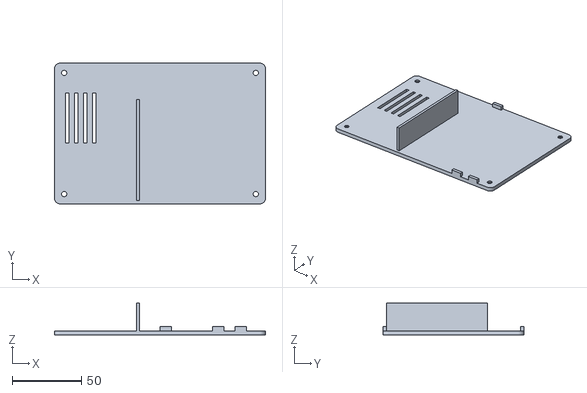
[picture p56: CAD file, 2026-10-24]
stl/wire_box_lid.stl
152.4 x 101.6 x 23.1
