melucasleite/mini-kitchen/stl/hinge-shims/hinge-shim-1.6mm.stl

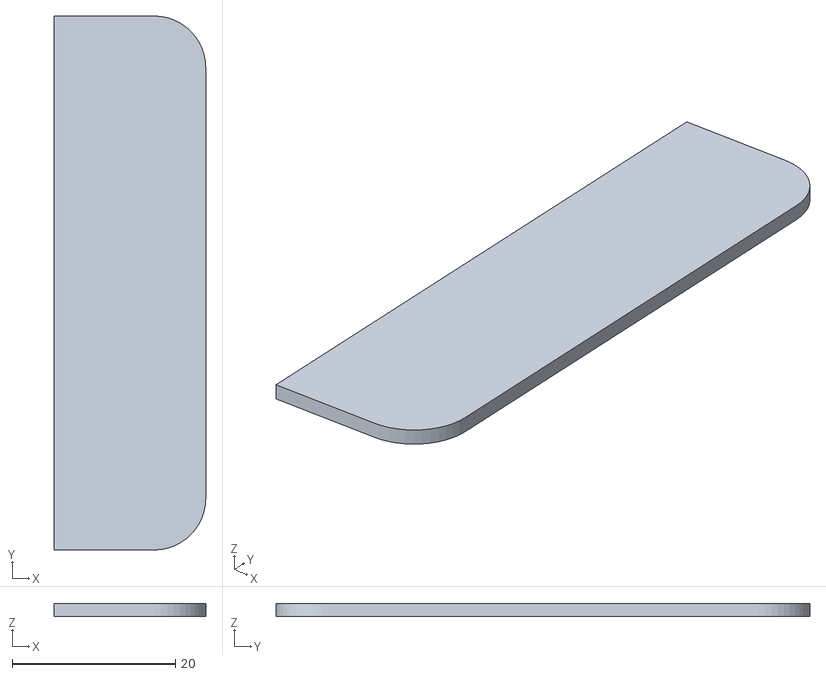
[picture p57: CAD file, 2026-10-24]
stl/hinge-shims/hinge-shim-1.6mm.stl
18.6 x 65.5 x 1.60
