melucasleite/mini-kitchen/stl/window_clip.stl

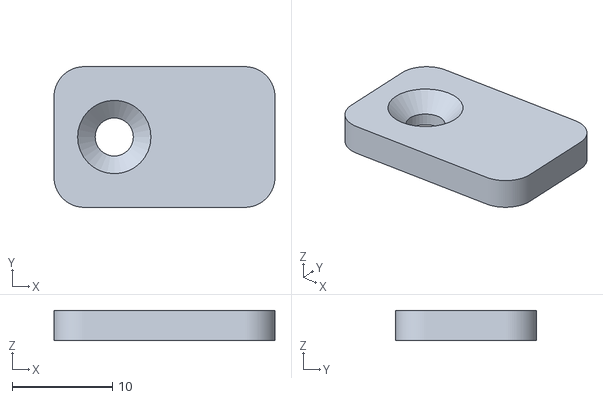
[picture p58: CAD file, 2026-10-24]
stl/window_clip.stl
22.0 x 14.0 x 3.00
