melucasleite/mini-kitchen/stl/hinge-shims/hinge-shim-1.4mm.stl

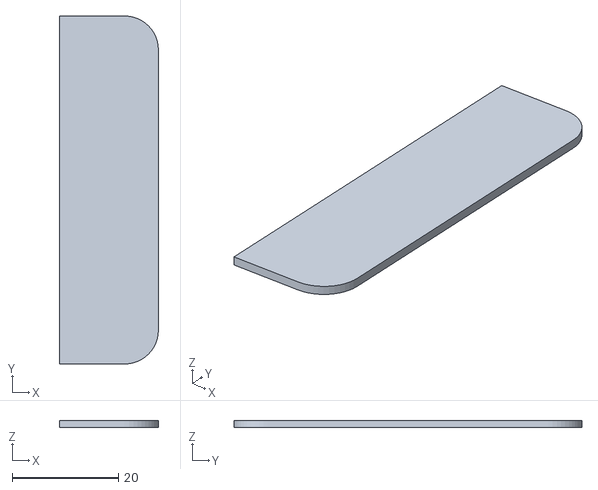
[picture p59: CAD file, 2026-10-24]
stl/hinge-shims/hinge-shim-1.4mm.stl
18.6 x 65.5 x 1.40
