melucasleite/mini-kitchen/stl/lid-M.stl

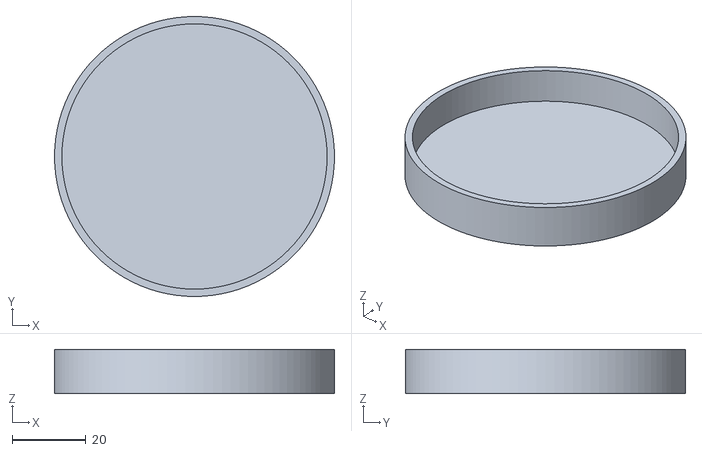
[picture p60: CAD file, 2026-10-24]
stl/lid-M.stl
75.8 x 75.8 x 12.0
