melucasleite/mini-kitchen/stl/fill_lid.stl

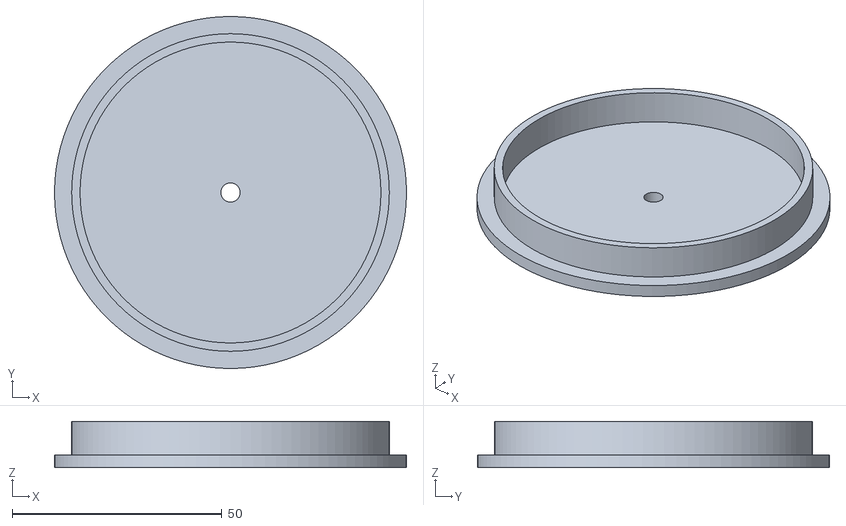
[picture p61: CAD file, 2026-10-24]
stl/fill_lid.stl
84.0 x 84.0 x 11.0
