melucasleite/mini-kitchen/stl/hinge-shims/hinge-shim-0.4mm.stl

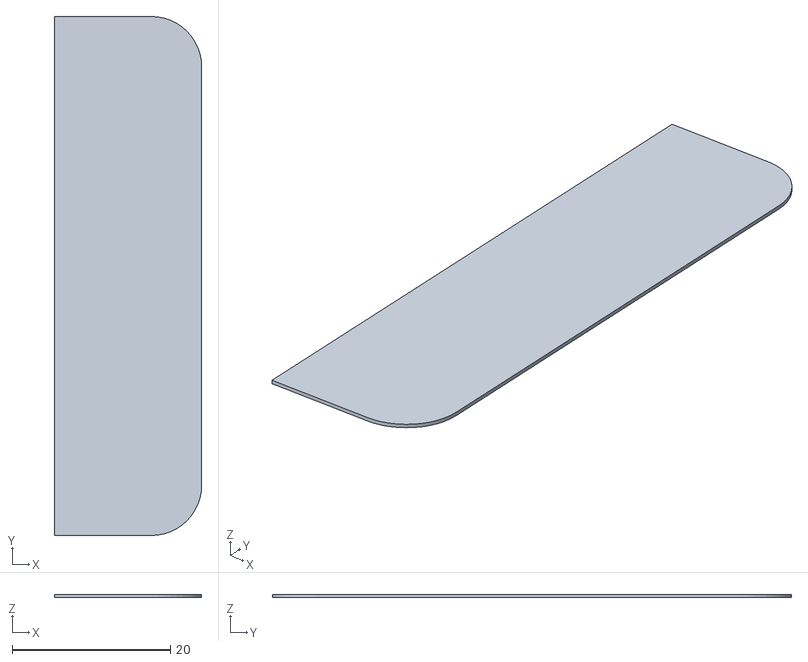
[picture p63: CAD file, 2026-10-24]
stl/hinge-shims/hinge-shim-0.4mm.stl
18.6 x 65.5 x 0.4
