melucasleite/mini-kitchen/stl/wire_box.stl

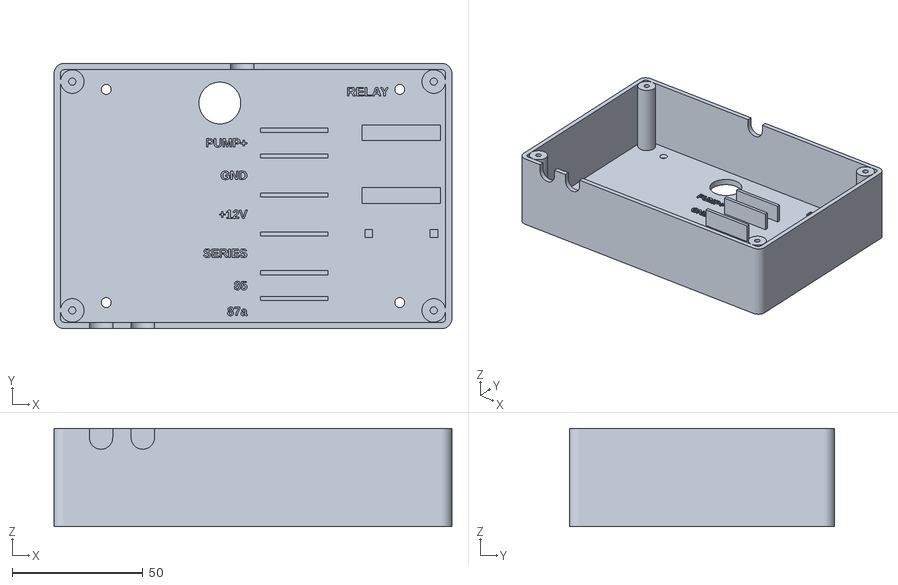
[picture p64: CAD file, 2026-10-24]
stl/wire_box.stl
152.4 x 101.6 x 37.6
