melucasleite/mini-kitchen/stl/coil.stl

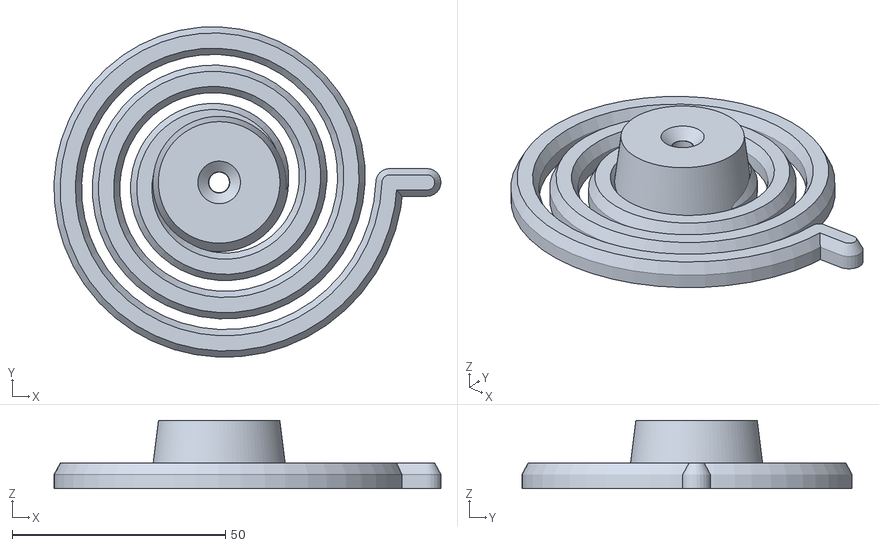
[picture p65: CAD file, 2026-10-24]
stl/coil.stl
90.8 x 77.5 x 16.0
