melucasleite/mini-kitchen/stl/fill_port.stl

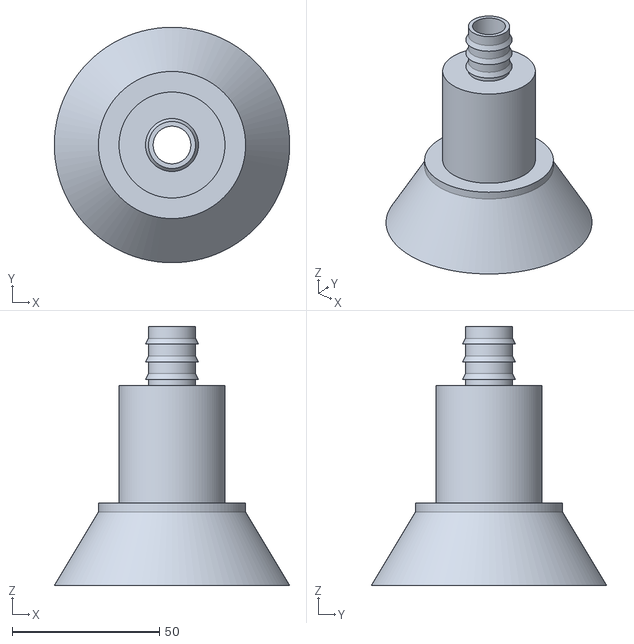
[picture p66: CAD file, 2026-10-24]
stl/fill_port.stl
80.0 x 80.0 x 88.0
