melucasleite/mini-kitchen/stl/canister-M.stl

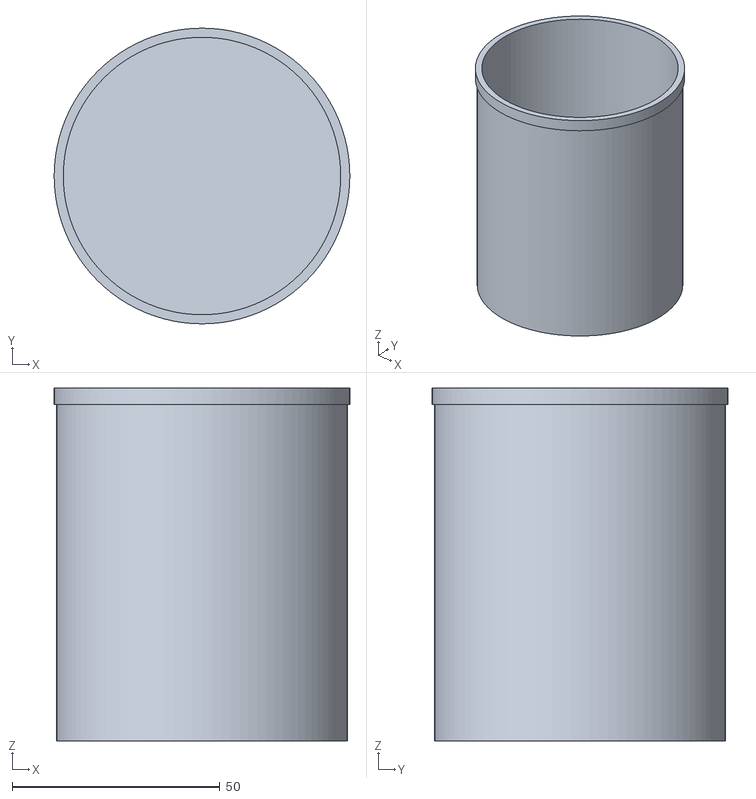
[picture p67: CAD file, 2026-10-24]
stl/canister-M.stl
71.2 x 71.2 x 85.0
