melucasleite/mini-kitchen/stl/funnel.stl

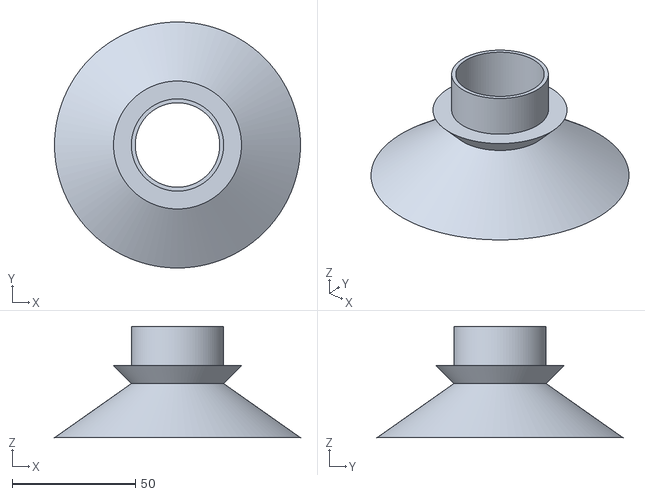
[picture p68: CAD file, 2026-10-24]
stl/funnel.stl
100.0 x 100.0 x 45.2
