melucasleite/mini-kitchen/stl/canister-L.stl

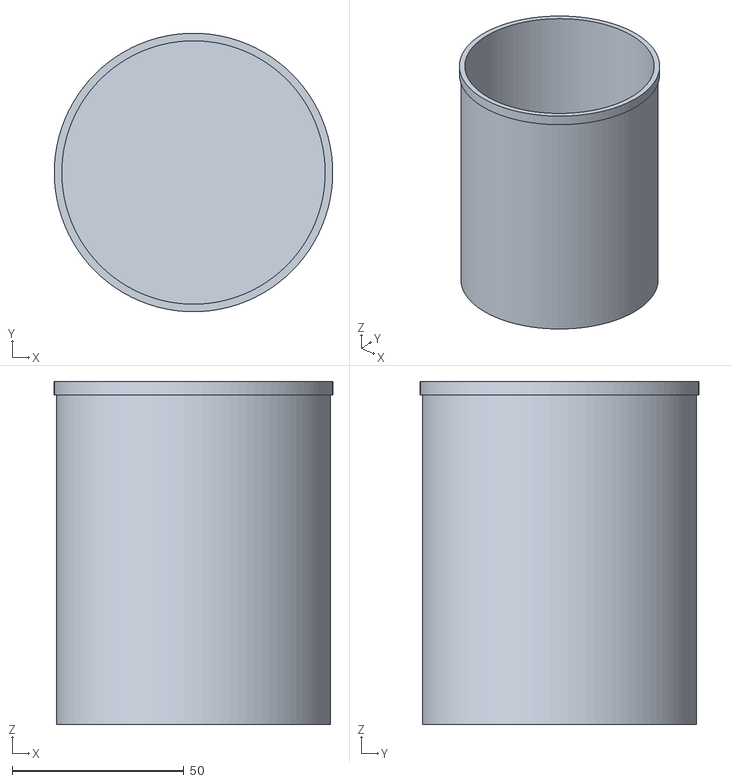
[picture p69: CAD file, 2026-10-24]
stl/canister-L.stl
81.2 x 81.2 x 100.0
