melucasleite/mini-kitchen/stl/bushing.stl

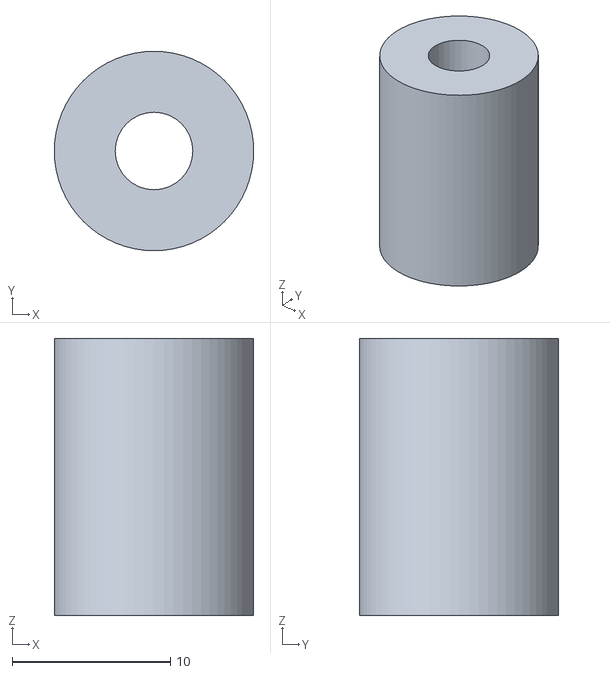
[picture p70: CAD file, 2026-10-24]
stl/bushing.stl
12.6 x 12.6 x 17.5
