melucasleite/mini-kitchen/stl/cap_plug.stl

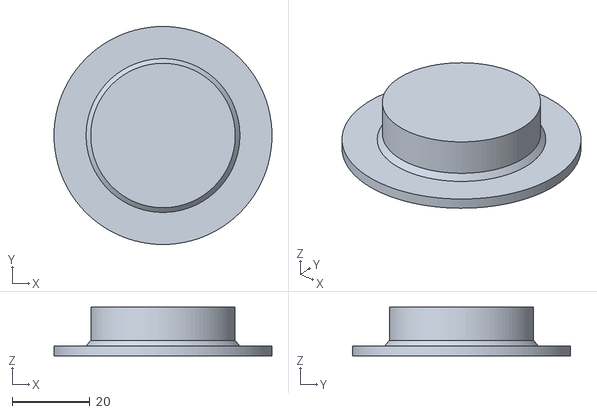
[picture p71: CAD file, 2026-10-24]
stl/cap_plug.stl
56.0 x 56.0 x 12.5
