melucasleite/mini-kitchen/stl/knob_boss.stl

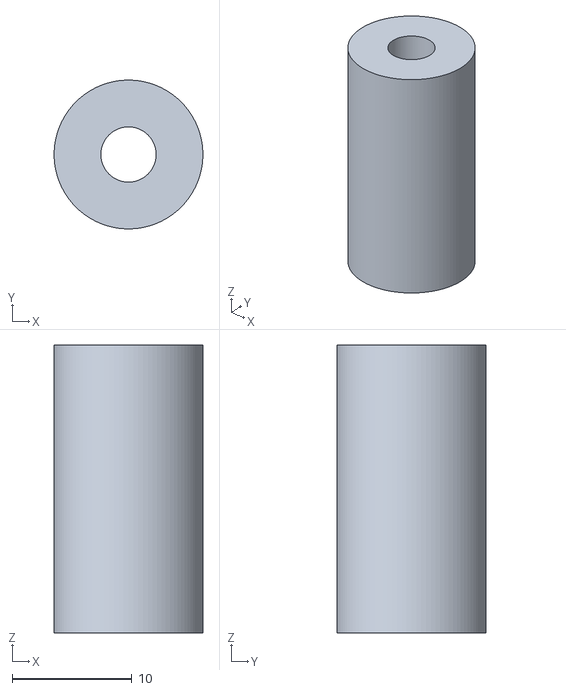
[picture p72: CAD file, 2026-10-24]
stl/knob_boss.stl
12.4 x 12.4 x 24.0
