melucasleite/mini-kitchen/stl/stove_knob.stl

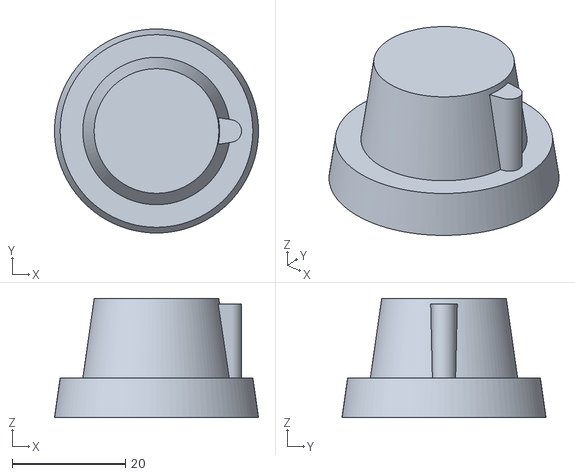
[picture p73: CAD file, 2026-10-24]
stl/stove_knob.stl
36.0 x 36.0 x 21.0
