melucasleite/mini-kitchen/stl/canister-S.stl

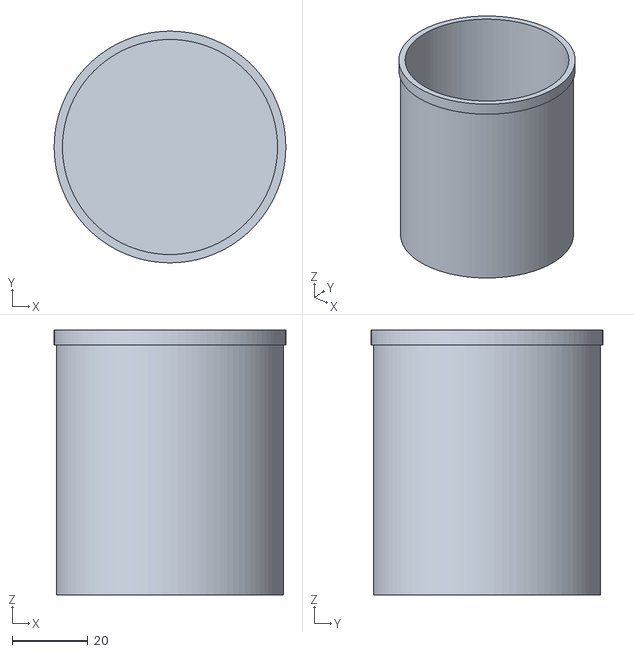
[picture p74: CAD file, 2026-10-24]
stl/canister-S.stl
61.2 x 61.2 x 70.0
