melucasleite/mini-kitchen/stl/drip_pan.stl

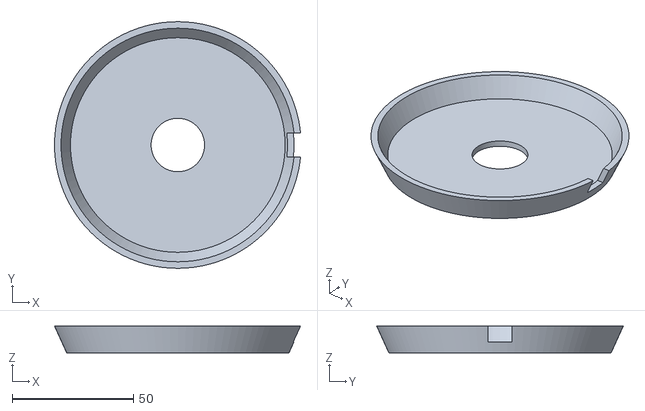
[picture p75: CAD file, 2026-10-24]
stl/drip_pan.stl
101.3 x 101.6 x 11.0
