melucasleite/mini-kitchen/stl/spatula.stl

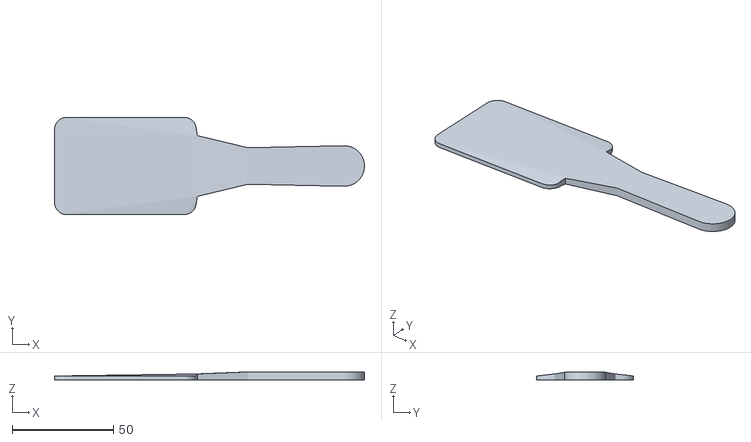
[picture p76: CAD file, 2026-10-24]
stl/spatula.stl
153.0 x 48.0 x 4.00
