melucasleite/mini-kitchen/stl/bezel.stl

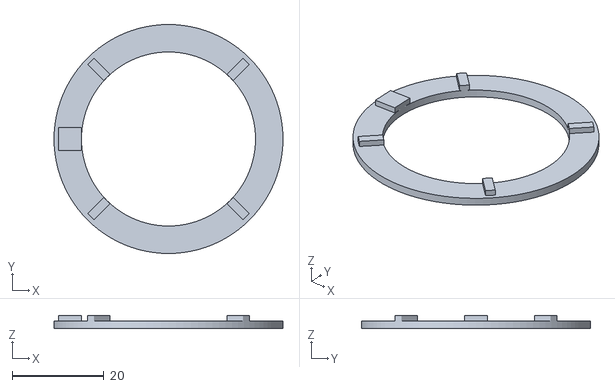
[picture p77: CAD file, 2026-10-24]
stl/bezel.stl
50.0 x 50.0 x 2.80
