melucasleite/mini-kitchen/stl/plate.stl

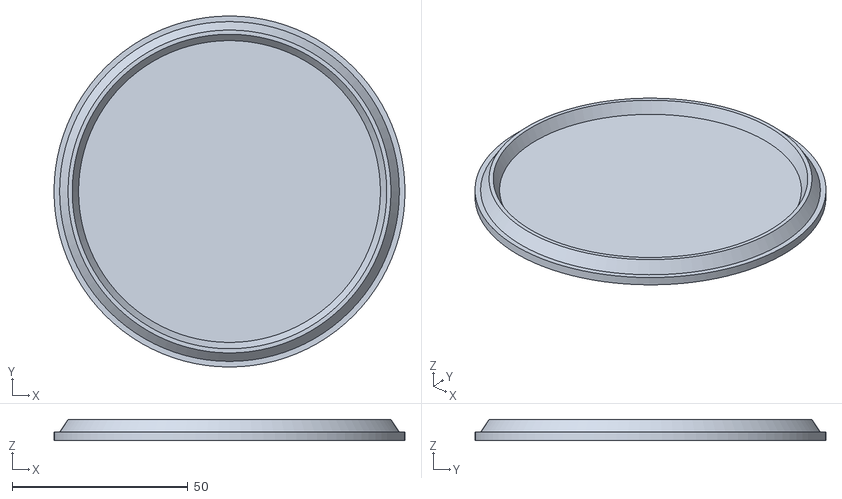
[picture p78: CAD file, 2026-10-24]
stl/plate.stl
100.0 x 100.0 x 6.00
