melucasleite/mini-kitchen/stl/lid-S.stl

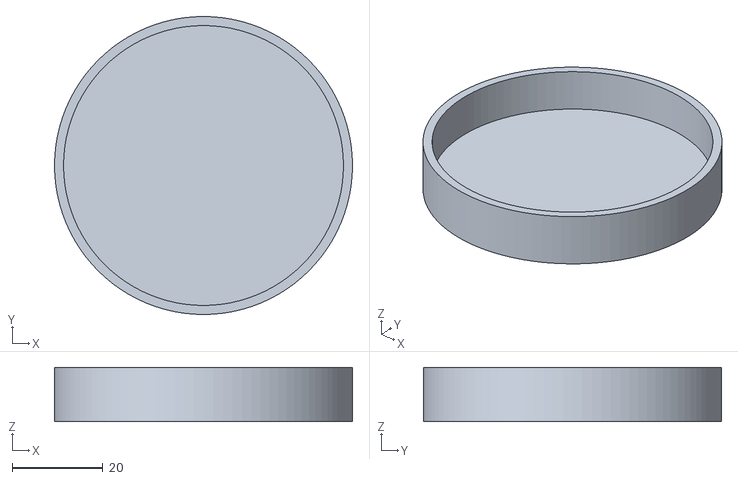
[picture p79: CAD file, 2026-10-24]
stl/lid-S.stl
65.8 x 65.8 x 12.0
