melucasleite/mini-kitchen/stl/pickup.stl

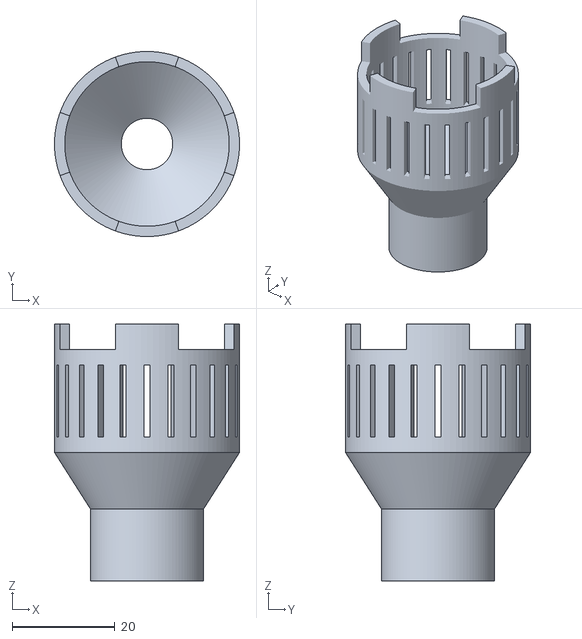
[picture p80: CAD file, 2026-10-24]
stl/pickup.stl
36.0 x 36.0 x 50.0
