melucasleite/mini-kitchen/params.scad

// GENERATED by design.py. Edit design.py, not this file. Units: inches.
T = 0.7200;
W = 45.8800;
D = 18.0000;
H = 45.0000;
HC = 23.0000;
TOE = 0.0000;
UP_D = 8.5000;
NOTCH_D = 9.5000;
INNER_W = 44.4400;
PANEL_L = 44.9400;
CTR_D = 17.2800;
UP_SHELF_D = 7.7800;
BACK_H = 44.2800;
SINK_BAY = 23.0000;
STOVE_BAY = 11.5000;
DRY_BAY = 8.5000;
DIV_D = 17.2800;
DIV_H = 22.0600;
STOVE_CX = 39.4100;
TANK_Z = 34.2500;
UP_DIV_D = 7.7800;
UP_DIV_H = 10.5300;
UP_BAY = 10.5700;
UP_OPEN_H = 10.0300;
PORT_D = 1.5000;
PORT_X = 6.0200;
PORT_Y = 9.8450;
PEG_Z = 27.0000;
PEG_L = 3.0000;
CLEAN_CX = 6.0200;
OVEN_Z = 9.7500;
DRY_Z = 11.0000;
SHELF_D = 16.2800;
OVEN_L = 11.7500;
DRY_L = 8.7500;
HINGE_L = 2.6000;
HINGE_LEAF_W = 0.7500;
HINGE_RECESS = 0.0550;
HINGE_IN = 2.0000;
FAUCET_X = 16.0325;
FAUCET_Y = 15.2500;
FAUCET_H = 7.0000;
FAUCET_REACH = 5.0000;
FAUCET_TOP = 9.3000;
PUMP_L = 8.3000;
PUMP_W = 4.3000;
PUMP_H = 3.5000;
PUMP_X0 = 1.5200;
PUMP_Z0 = 16.5000;
WBOX_X0 = 10.4200;
WBOX_Z0 = 11.6000;
WBOX_W = 6.0000;
WBOX_H = 4.0000;
WBOX_D = 1.6000;
CORD_X = 12.9200;
CORD_Z = 15.0000;
JUG_W = 10.0000;
JUG_D = 10.0000;
JUG_H = 14.0000;
JUG_NECK_D = 2.2500;
JUG_NECK_IN = 1.1250;
NECK_Y = 9.8450;
DIRTY_FLOAT_Z = 12.0000;
CLEAN_FLOAT_Z = 2.0000;
JUG_Y0 = 0.9700;
CLEAN_X0 = 1.0200;
DIRTY_X0 = 11.4200;
DIRTY_CX = 16.4200;
JUG_HOLE = 10.5000;
JUG_NOTCH_D = 11.2200;
FUNNEL_D = 3.9370;
DOOR_W = 11.3594;
DOOR_H = 21.3725;
DRY_DOOR_W = 8.3125;
OVEN_DOOR_W = 11.3125;
OVEN_DOOR_H = 12.3425;
WARM_DOOR_H = 8.1225;
REVEAL = 0.0938;
WIN_W = 8.5000;
WIN_H = 6.5000;
WIN_R = 0.5000;
ACR_W = 10.0000;
ACR_H = 8.0000;
ACR_T = 0.1250;
ACR_SLACK = 0.2000;
WIN_POCKET = 0.1300;
PANEL_DEPTH = 0.1300;
FRAME = 1.7500;
WIN_CZ = 5.0000;
HANDLE_CC = 3.7800;
HANDLE_Z = 11.3425;
MARK_D = 0.3500;
BURNER_D = 4.0000;
BURNER_GROOVE_R = 1.5000;
BURNER_Y = 4.5000;
KNOB_Y = 1.3000;
SINK_RIM = 15.0000;
SINK_CUT = 14.3750;
SINK_CUT_R = 1.5000;
SINK_DRAIN = 2.0000;
SINK_CX = 16.0325;
SINK_CY = 9.0000;
KNOB_HOLE = 0.5000;
DOOR_KNOB_IN = 0.8750;
BIT = 0.5000;
DADO = 0.2500;
DADO_W = 0.7350;
DADO_R = 0.2500;
BURNERS = [[37.0350, 4.5000], [41.7850, 4.5000], [37.0350, 9.5000], [41.7850, 9.5000]];
KNOBS = [[35.5100, 1.3000], [38.1100, 1.3000], [40.7100, 1.3000], [43.3100, 1.3000]];
UDIV_X = [11.2900, 22.5800, 33.8700];
PEG_Y = [11.0000, 15.0000];
SINK_BOWL = [12.0, 10.0, 5.0];
