melucasleite/mini-kitchen/(list of files, cad)

Other CAD files:
stl/washer.stl
