melucasleite/mini-kitchen/previews/printed.png

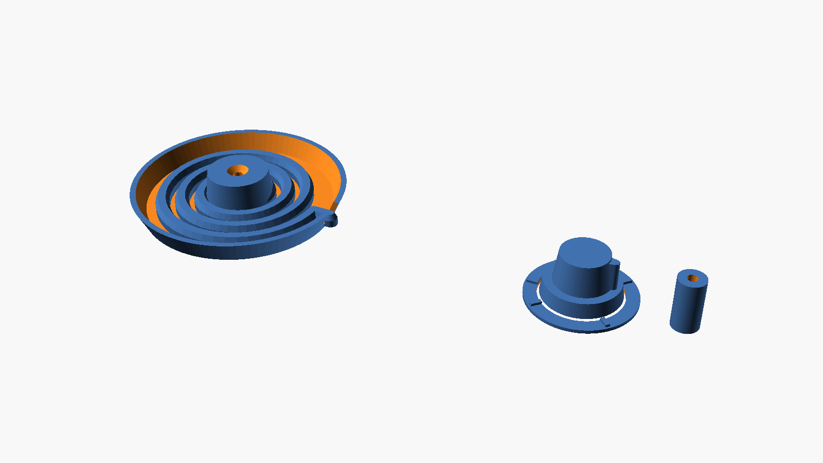
previews/printed.png
