melucasleite/mini-kitchen/(commit log)

2026-10-24 Mini Kitchen: a toddler play kitchen with a real sink and an oven window
    [bezel.stl, bushing.stl, canister-L.stl, canister-M.stl, canister-S.stl, cap_plug.stl, coil.stl, drip_pan.stl]
2026-10-29 Joinery reads screwed (glue optional); knob bushings on the four knobbed doors, not eight
